JCA98/Proyecto-el-ctrico/Documentos importantes/ModeladoYControlPMSM.pdf

# Modelado y control de la máquina sincrónica de imanes permanentes

Mauricio Espinoza B.
28 de mayo de 2020

El presente documento pretende brindar los fundamentos del modelado y control de la máquina sincrónica de imanes permanentes, PMSM (también conocida como máquina ac de imanes permanentes, PMAC machine, del inglés). Tanto el modelado como el control se hacen en forma vectorial (se usará negrita para denotar una variable vectorial), donde un vector x de dos dimensiones tiene parte real e imaginaria, es decir: xαβ = xα + jxβ. Además, se utilizarán vectores de 3 dimensiones reales de la forma: xabc = [xa, xb, xc]

. A menos que se diga lo contrario, todas las variables serán medidas línea a neutro y de forma instantánea en este documento no se usan fasores. El subíndice “s” se utilizará para variables de estator, mientras que las variables con subíndice “r” serán del rotor.
I. MODELADO DE LA MÁQUINA SINCRÓNICA DE IMANES PERMANENTES

I-A. Ecuaciones dinámicas en coordenadas abc

La máquina sincrónica de imanes permanentes (PMSM, por sus siglas en inglés) se muestra en la Fig. 1.

+

+

+

N
S

Figura 1. Modelo eléctrico de la máquina sincrónica de imanes permanentes
donde el rotor de la máquina posee un imán permanente que proporciona el campo magnético que interactúa con el campo magnético producido en el estator. Para definir el sentido de las corrientes se asume “convención de motor”, es decir, las corriente entran al estator (esto es independiente de la aplicación de la máquina). Por lo tanto, es posible plantear el siguiente sistema de ecuaciones a partir del circuito de la Fig. 1:

vsa = Risa +

dλsa
dt | (1)

vsb = Risb +

dλsb
dt | (2)

vsc = Risc +

dλsc
dt | (3)

Donde el subíndice “s” se refiere a stator. Esta expresión puede ser representada en forma compacta utilizando notación vectorial de la siguiente manera:

vsabc = Risabc +

dλsabc
dt | (4)

donde vsabc = [vsa, vsb, vsc]

es el vector trifásico de tensiones de entrada, isabc = [isa, isb, isc]
| son las corrientes de estator,

λsabc = [λsa, λsb, λsc]

es el vector de flujo que llega al estator, mientras que R es la resistencia de estator. Como se indicó anteriormente, todas las variables son instantáneas y medidas entre fase y neutro (si aplica).

Aunque el modelo descrito en (4) es válido, él posee tres inconvenientes:

1. Las variables que utiliza son linealmente dependientes. Por ejemplo: isa + isb + isc = 0. Esta característica lo hace poco útil para efectos de representar la dinámica de una máquina trifásica.
2. Las variables que utiliza son sinusoidales, lo cual no es atractivo para la implementación de sistemas de control a frecuencia variable.

3. El flujo magnético del estator depende tanto de la corriente del estator como del flujo del rotor. Por lo tanto, es necesario determinar la relación existente entre estas variables para lograr un buen control de las corrientes de estator.

En lo siguiente se detallará cómo resolver cada uno de estos inconvenientes aplicando transformaciones lineales específicas o realizando cambios de variable.

I-B. Modelado de la máquina en coordenadas αβ

El primer inconveniente del modelo definido en (4) puede ser solventado aplicando la transformada de Clarke¹
. Cuando se
trabajan con señales trifásicas balanceadas, esta transformada convierte un espacio de tres variables trifásicas desfasadas 120◦ a dos variables desfasadas 90◦ por medio de la transformación:
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
- (5)

donde x es una variable trifásica cualquiera (tensión, corriente, flujo magnético, etc.), [xα, xβ]

es el vector en coordenadas αβ y [xa, xb, xc]
es el vector en coordenadas abc² . En notación vectorial compleja, el vector en coordenadas αβ se puede escribir como xαβ = xα + jxβ. Utilizando esta notación, la expresión (4) se puede escribir como:

vsαβ = Risαβ +

dλsαβ
dt | (6)

donde todas las variables son ahora de la forma a + jb, es decir: vsαβ = vsα + jvsβ, isαβ = isα + jisβ, λsαβ = λsα + jλsβ. Con este procedimiento, se ha pasado de un sistema trifásico redundante a uno bifásico cuyas variables son linealmente independientes. Así, al modelo definido en (6) se le llama el modelo de la máquina en coordenadas αβ.

I-C. Modelado de la máquina en coordenadas dq

Para eliminar el componente sinusoidal del modelo dado en (6), se puede comenzar por identificar el motivo de su presencia expresando los vectores complejos en notación polar. Es decir, definiendo:

vsαβ = vsα + jvsβ = |vsαβ|e

j(θe+θv)
| (7)
isαβ = isα + jisβ = |isαβ|e
j(θe+θi) | (8)

λsαβ = λsα + jλsβ = |λsαβ|e

j(θe+θλ)
| (9)

donde θe =

R
ωedt es el ángulo eléctrico y ωe es la frecuencia eléctrica de la máquina. En las expresiones anteriores, θv, θi y θλ son ángulos de desfase entre las variables eléctricas y se consideran constantes. Nótese que al utilizar la notación polar, se ha evidenciado que los vectores están girando a una velocidad angular ωe igual a la frecuencia eléctrica de las señales en coordenadas abc. De hecho, considerando el vector de tensiones como ejemplo, se puede escribir:

vsαβ = |vsαβ|e

j(θe+θv)

= |vsαβ|e

jθv
- e
jθe | (10)

donde la parte giratoria del vector (e

jθe

) se ha separado completamente. La parte restante, |vsαβ|e | jθv , es en realidad un vector
de fase constante que no gira, pues como se dijo antes, el ángulo θv es constante. De esta manera, para eliminar la parte giratoria del modelo (6) basta con multiplicarlo por e

−jθe
, pues e

jθe
- e

−jθe = 1, expresión que no es un vector giratorio.

Formalmente, el proceso de multiplicar un sistema por e

−jθe se denomina transformación dq, y fue propuesta por Robert H. Park en 1929. Así, al tener un vector en coordenadas αβ, este vector se puede pasar a coordenadas dq de la siguiente manera:

xdq = xαβe

−jθe | (11)

y del mismo modo, la transformada dq inversa estaría dada por:

xαβ = xdqe

jθe
| (12)

En el caso específico de la tensión vectorial utilizada como ejemplo, se tendría que:

vsdq = vsαβe

−jθe

1ver: https://es.wikipedia.org/wiki/Edith_Clarke.
2A menara de ejemplo, considérese un sistema trifásico dado por xa = X cos(θe +θ0), xb = X cos(θe −120◦ +θ0), xc = X cos(θe + 120◦ +θ0). Al aplicar la transformada de Clarke se demuestra que: xα = X cos(θe + θ0) y xβ = X sin(θe + θ0), que son dos variables desfasadas 90◦.

= |vsαβ|e

j(θe+θv)
| | {z | }
| vsαβ

e

−jθe

= |vsαβ|e

jθv

= vsd + jvsq | (13)

Entonces, aplicando la transformada dq al sistema (6) (i.e. multiplicando por e

−jθe
) se obtiene:

(vsαβ) e

−jθe = (Risαβ) e

−jθe +

dλsαβ

dt
e

−jθe
| (14)

lo que resulta en:

vsdq = Risdq +

dλsdq
dt | + jωeλsdq | (15)

donde el último miembro de (15) se debe a que se debe aplicar un “tip matemático” para calcular
dλsαβ

dt
e

−jθe
| | . Por la regla
de la cadena se sabe que:
dλsαβe

−jθe
dt | =
dλsαβ
dt e | −jθe + (λsαβ)

de⁻jθe
dt

⇒

dλsαβ

dt
e

−jθe =

dλsαβe

−jθe
dt | − (λsαβ)

de⁻jθe
dt | (16)

pero − (λsαβ)

de⁻jθe
dt = − (λsαβ) e

−jθe

d(−jθe)
dt = −jωe (λsαβ) e

−jθe
(derivada de una exponencial y definición de θe) y además d(λsαβe

−jθe )
dt | =

dλsdq
dt (definición de la transformada dq). Entonces:
dλsαβ

dt
e

−jθe =

dλsdq
dt | + jωeλsdq | (17)

Finalmente, el modelo definido en (15) es el modelo de la máquina de imanes permanentes en coordenadas dq, pero no se ha simplificado al máximo pues aún se utiliza el flujo magnético del estator, que es compuesto por la corriente de estator y el flujo magnético de rotor, lo que representa el tercer inconveniente que se debía resolver.

El flujo que llega al estator de la máquina está compuesto por el flujo producido por las corrientes del estator y por el flujo producido por el imán del rotor que es capaz de llegar hasta el estator. Matemáticamente, y utilizando coordenadas dq, esto se escribe como:

λsdq = Lisdq + λrdq | (18)

siendo L la inductancia de los devanados de estator y λrdq el flujo magnético producido por el rotor y que llega al estator. Así, sustituyendo (18) en (15) resulta:

vsdq = Risdq +

d
dt (Lisdq + λrdq)
| | {z | }

λsdq

+jωe (Lisdq + λrdq)
| | {z | }

λsdq

⇒ | (19)

vsdq = Risdq + L

disdq
dt +

dλrdq
dt | + jωeLisdq + jωeλrdq | (20)

donde ahora solo se utilizan las corrientes y tensiones de estator, el flujo magnético de rotor y la frecuencia eléctrica como variables en el modelo. El modelo dado en (20) se denomina modelo dq general y sin una orientación específica, pues no se ha definido aún qué ángulo inicial se considerará en el sistema. El proceso de elegir el ángulo inicial del sistema se denomina orientación del sistema, y dependiendo de su elección se afectará el valor de θe, θv, θi
, etc. Para visualizar los efectos de la orientación del eje dq en el modelo (20), este modelo se separá en los componentes real (d) e imaginario (q), resultando en:

vsd = Risd + L

disd
dt +

dλrd
dt − ωeLisq − ωeλrq | (21)

vsq = Risq + L

disq
dt +

dλrq
dt + ωeLisd + ωeλrd | (22)

Aunque es posible orientar el modelo descrito en (21) y (22) de muchas maneras, para efectos de control es conveniente orientar el eje dq en el flujo de rotor. Esto produce que λrdq = λrd + j0 (i.e. λrq = 0). Además, si se supone flujo de rotor constante (lo que es válido pues la máquina es de imanes permanentes), se tiene: dλrd
dt = 0 y

dλrq
dt = 0. Por lo tanto, (21) y
(22) resultan en:

vsd = Risd + L

disd
dt − ωeLisq | (23)

vsq = Risq + L

disq
dt + ωeLisd + ωeλrd | (24)

Finalmente, (23) y (24) son el el modelo dinámico de la máquina sincrónica de imanes permanentes en coordenadas dq orientadas en el flujo de rotor. Este modelo es el más utilizado en el control y modelado de las máquinas de imanes permanentes.

I-D. Modelo electromecánico de la máquina

El modelo electromecánico de las máquinas rotativas es similar en todos los casos, y está dado por:

J

dωr
dt = Te − TL | (25)

donde ωr es la velocidad rotacional mecánica, en rad/s, TL y Te son los torques de carga y eléctrico, en Nm, y J es la inercia rotacional, en kgm²
. Nótese que pωr = ωe, donde p es el número de pares de polos. No obstante, es poco común trabajar directamente con el torque eléctrico. En su lugar, se suele trabajar con las corrientes de la máquina, que son más fáciles de medir. En lo siguiente, se muestra cómo modelar el torque eléctrico en función de otras variables de la máquina.

En forma general, se puede demostrar que la potencia activa trifásica de un sistema cuyas variables están expresada en coordenadas dq es:

pe =

3
2

< {(vsd + jvsq) (isd − jisq)} ⇒

pe =

3
2
(vsdisd + vsqisq) | (26)

donde el factor 3
2

se debe a la transformada de Clarke utilizada (conservativa en amplitud).

Ahora bien, considerando que la resistencia del devanado de la máquina es pequeña y que las corrientes dq están en estado estacionario, las expresiones (23) y (24) resultan:

vsd ≈ −ωeLisq | (27)
vsq ≈ ωeLisd + ωeλrd | (28)

y sustituyendo (27) y (28) en (26) se llega a que la potencia eléctrica de la máquina es:

pe ≈

3
2
ωeλrdisq | (29)

Finalmente, considerando que pe ≈

Teωe
p

, el torque eléctrico (Te) de la máquina se obtiene al dividir (29) por ωe
p
| , es decir:

Te ≈

3
2
pλrdisq | (30)

La expresión (30) indica que cuando se utiliza orientación en el flujo de rotor, la máquina sincrónica de imanes permanentes se puede controlar como si fuera una máquina dc, donde el flujo y el torque están desacoplados. Por ejemplo, en este caso el flujo de rotor es impuesto por el imán permanente, mientras que la corriente de cuadratura define el torque aplicado a la máquina, es decir, la corriente de eje de cuadratura resulta equivalente a la corriente de armadura de la máquina dc, lo cual posibilita la implementación de estrategias de control con una respuesta dinámica bastante alta. De esta manera, sustituyendo
(30) en (25) se obtiene:

J

dωr
dt =

3
2
pλrdisq − TL | (31)

Finalmente, (31), (24) y (23) representan el modelo de la máquina sincrónica de imanes permanentes con orientación en el flujo de rotor. Estas ecuaciones se colocan juntas y despejando los estados del sistema para simplicidad del lector:

L

disd
dt = −Risd + ωeLisq + vsd | (32)

L

disq
dt = −Risq − ωeLisd − ωeλrd + vsq | (33)

J
p

dωe
dt =

3
2
pλrdisq − TL | (34)

donde se ha utilizado el hecho de que ωe = ωrp para dejar el modelo en función de los estados ωe, isd, isq y las entradas vsd, vsq (que son las tensiones que se pueden manipular) y λrd, que es una entrada que se considera constante.

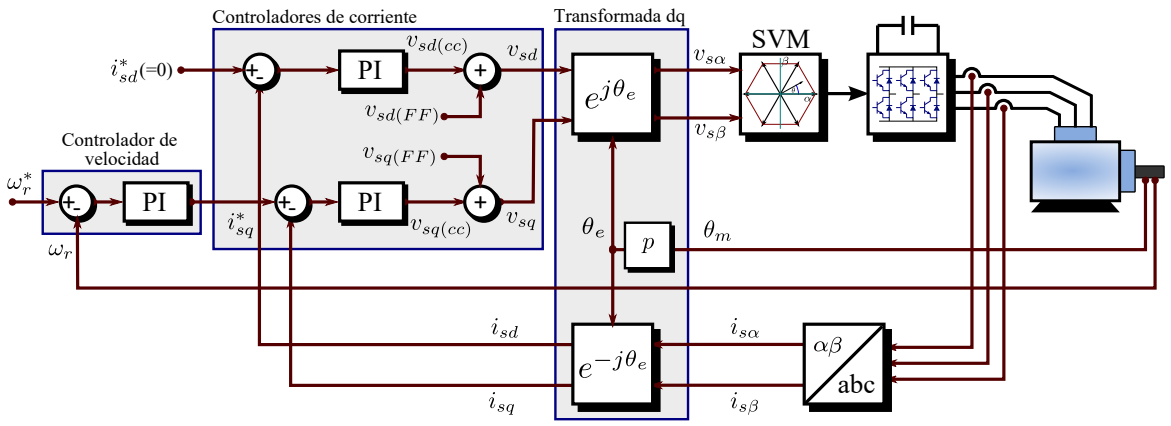
[picture p1: figure]
SVM; abc; Controladores de corriente; Controlador de velocidad; Transformada dq

Figura 2. Control vectorial orientado en el flujo de rotor para la PMSM

II. CONTROL DE LA MÁQUINA SINCRÓNICA DE IMANES PERMANENTES

II-A. Medición de las variables eléctricas disponibles en la máquina

Dado que el modelado de la máquina se realizó en coordenadas dq orientadas en el flujo de rotor de la máquina, es necesario transformar las variables reales de la máquina, en coordenadas abc, a coordenadas dq con el ángulo eléctrico del vector de flujo de rotor. Para ello, se puede aplicar cualquiera de los dos procedimientos descritos en [1], con el fin de definir el ángulo de giro inicial de la máquina. Una vez definido este ángulo, se puede aplicar la transformada abc a dq y dq a abc, esto se muestra en la figura 2. Nótese que el ángulo eléctrico θe es definido en función del ángulo mecánico θm, utilizando los pares de polos de la máquina, p.

II-B. Control de las corrientes de la máquina

A partir de (23) y (24), se determina que las corrientes isd e isq pueden ser controladas manipulando, respectivamente, las tensiones vsd y vsq. Sin embargo, nótese que los últimos miembros de (23) y (24) corresponden a términos de acoplamiento, los cuales pueden ser considerados como perturbaciones desde un punto de vista de control. Para eliminar estas perturbaciones, las tensiones por aplicar a la máquina pueden ser definidas como:

vsd = vsd(c) + vsd(F F )
(35)

vsq = vsq(c) + vsq(F F )
(36)

donde el subíndice (c) indica “definido por un controlador” y el subíndice (F F) indica “FeedForward” (prealimentación, compensación o desacople). Las variables definidas con el subíndice (F F) son las responsables de eliminar los acoples del modelo de la máquina. Por ejemplo, si vsd(F F ) y vsq(F F ) se definen como:

vsd(F F ) = −ωeLisq | (37)
vsq(F F ) = ωeLisd + ωeλrd | (38)

al sustituir (37) y (38) en (23) y (24), se obtiene:

vsd(c) = Risd + L

disd
dt | (39)

vsq(c) = Risq + L

disq
dt | (40)

Por lo que los acoples entre las corriente dq han sido eliminados, y la función de transferencia entre las corrientes isd e isq y las tensiones vsq(c) y vsq(c)
resultan en plantas de primer orden que pueden ser fácilmente controlables por PIs convencionales. Estos PIs se pueden sintonizar utilizando cancelación de polos y ceros, para lograr el ancho de banda a lazo cerrado buscado.

II-C. Control de la velocidad

Para obtener la planta de velocidad se pueden aplicar dos enfoques. En ambos se utiliza la corriente isq como variable manipulada:

1. Analítico: de (30) en (25), se obtiene:

J

dωr
dt =

3
2
pλrdisq − TL | (41)

por lo tanto, si el flujo se considera constante (lo cual es usual en la mayoría de las aplicaciones), la función de transferencia entre ωr(s) y isq(s), considerando TL = 0, es:

ωr(s)
isq(s)

=

3pλrd
2Js

(42)

2. Experimental: teniendo el lazo de corriente de cuadratura cerrado, y el lazo de velocidad abierto, aplicar un escalón en el valor deseado i

∗
sq y medir la velocidad mecánica resultante ωr. Con este enfoque, se obtendría una función de transferencia experimental que debería ser semejante a la obtenida con el enfoque analítico, pero con la ventaja de que se incorporan otras dinámicas no modeladas. Es importante notar que esta prueba debe realizarse sin torque de carga aplicado (esto es, TL = 0), y que la respuesta de la velocidad debe ser registrada con cuidado, pues su relación con la corriente isq es integrante (ver (42)) y por tanto la máquina acelerará continuamente. No existe un valor estándar para el escalón que se debe aplicar en isq durante esta prueba, pero el 10 % del valor nominal de la corriente de la máquina debería funcionar sin problemas.

III. APLICACIONES EÓLICAS DE LA MÁQUINA DE IMANES PERMANENTES

to be done :)

REFERENCIAS

[1] V. Slapk, K. Kyslan, F. Mejdr, and F. Durovsky, “Determination of Initial Commutation Angle Offset of Permanent Magnet Synchronous Machine - An Overview and Simulation,” Acta Electrotechnica et Informatica, vol. 14, DOI 10.15546/aeei-2014-0035, (http://dx.doi.org/10.15546/aeei-2014-0035) no. 4, pp. 17–22, 2014.
