JCA98/Proyecto-el-ctrico/PCB/diseñosjasiel/0805YC104KAT2A/3D/0805YC104KAT2A.stp

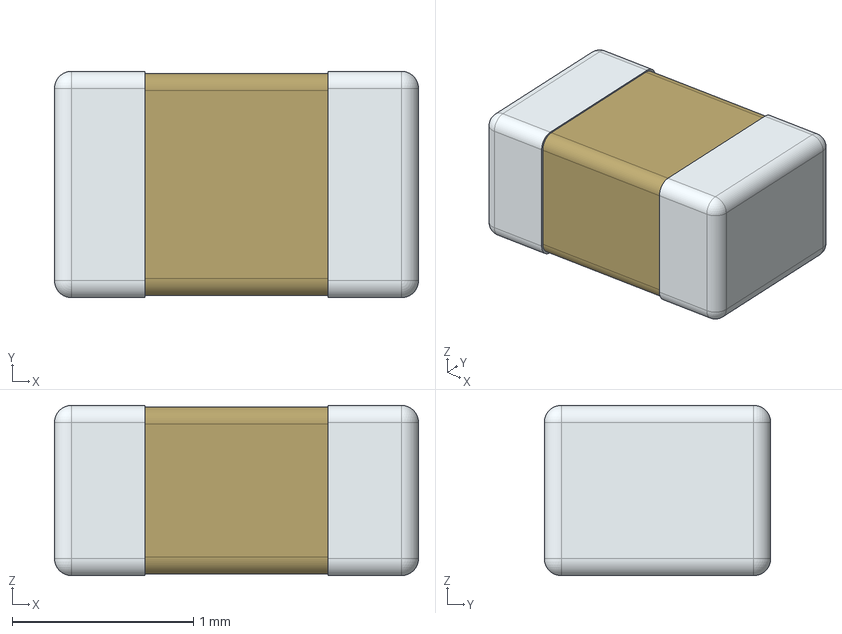
[picture p2: CAD file, 2021-06-20]
PCB/diseñosjasiel/0805YC104KAT2A/3D/0805YC104KAT2A.stp
2.01 x 1.25 x 0.94 mm
