JCA98/Proyecto-el-ctrico/PCB/diseñosjasiel/224PPB250K/3D/224PPB250K.stp

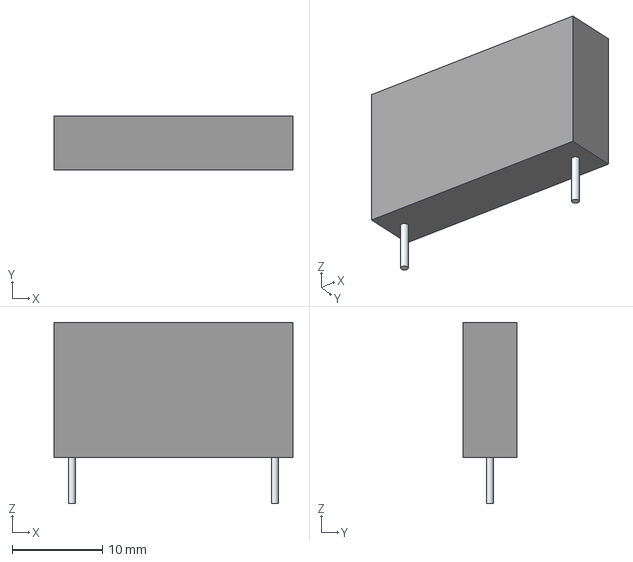
[picture p3: CAD file, 2021-06-16]
PCB/diseñosjasiel/224PPB250K/3D/224PPB250K.stp
26.5 x 6.00 x 20.1 mm
Leads
