JCA98/Proyecto-el-ctrico/PCB/diseñosjasiel/ALS70A362KE250/3D/ALS70A362KE250.stp

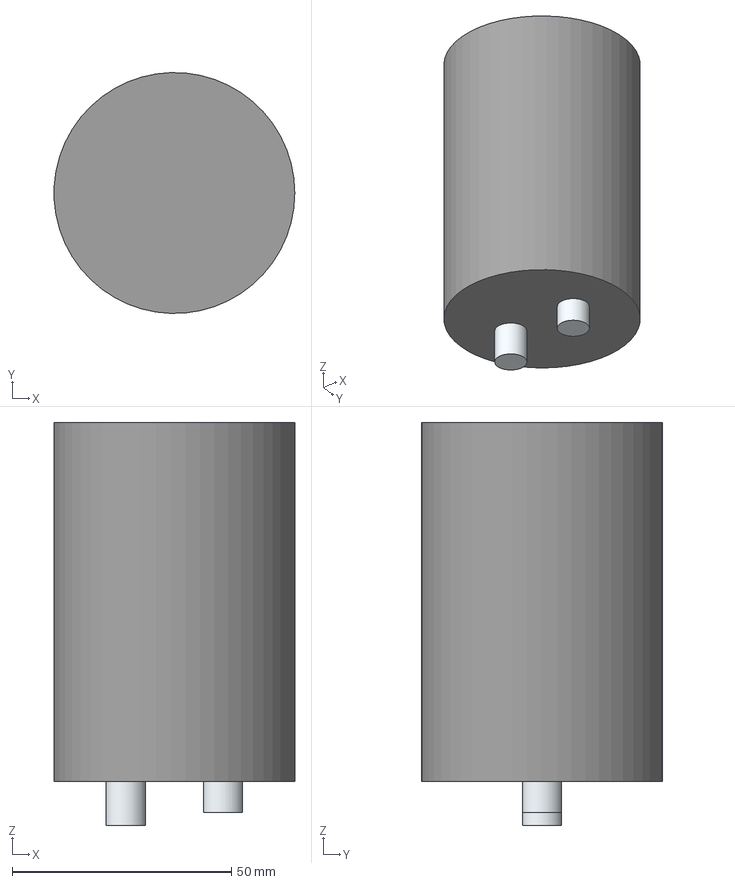
[picture p4: CAD file, 2021-07-05]
PCB/diseñosjasiel/ALS70A362KE250/3D/ALS70A362KE250.stp
54.9 x 55.0 x 92.0 mm
SimpleBody
Pin1
Pin2
