JCA98/Proyecto-el-ctrico/PCB/diseñosjasiel/C0805Y102K3RACTU/3D/C0805Y102K3RACTU.stp

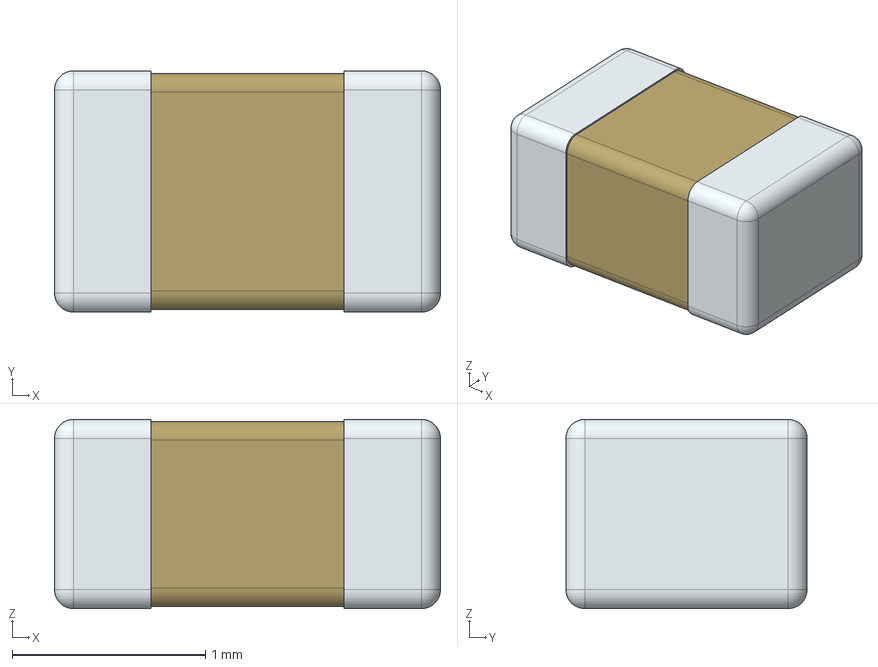
[picture p5: CAD file, 2021-06-20]
PCB/diseñosjasiel/C0805Y102K3RACTU/3D/C0805Y102K3RACTU.stp
2.00 x 1.25 x 0.98 mm
