JCA98/Proyecto-el-ctrico/PCB/diseñosjasiel/FCH041N60F/3D/FCH041N60F.stp

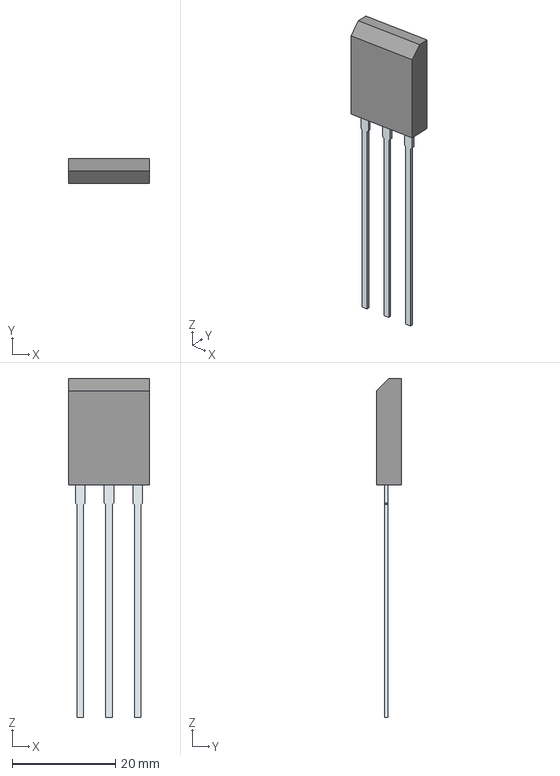
[picture p6: CAD file, 2021-06-16]
PCB/diseñosjasiel/FCH041N60F/3D/FCH041N60F.stp
15.6 x 4.82 x 65.5 mm
PinsArray
