JCA98/Proyecto-el-ctrico/PCB/User Library-CR2012-0805.step

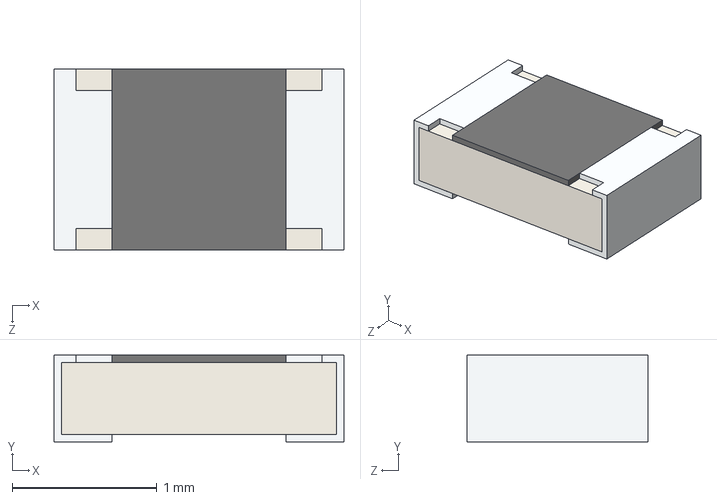
[picture p7: CAD file, 2021-06-15]
PCB/User Library-CR2012-0805.step
2.00 x 0.6 x 1.25 mm
