JCA98/Proyecto-el-ctrico/(list of files, cad)

Other CAD files:
PCB/diseñosjasiel/0805YC104KAT2A/3D/0805YC104KAT2A.stl
PCB/diseñosjasiel/0805YC104KAT2A/DEHDL/0805yc104kat2a/chips/chips.prt
PCB/diseñosjasiel/224PPB250K/3D/224PPB250K.stl
PCB/diseñosjasiel/224PPB250K/DEHDL/224ppb250k/chips/chips.prt
PCB/diseñosjasiel/ALS70A362KE250/3D/ALS70A362KE250.stl
PCB/diseñosjasiel/C0805Y102K3RACTU/3D/C0805Y102K3RACTU.stl
PCB/diseñosjasiel/FCH041N60F/3D/FCH041N60F.stl
PCB/diseñosjasiel/FCH041N60F/DEHDL/fch041n60f/chips/chips.prt
