JCA98/Proyecto-el-ctrico/Schematic/H-Bridge schematic.PDF

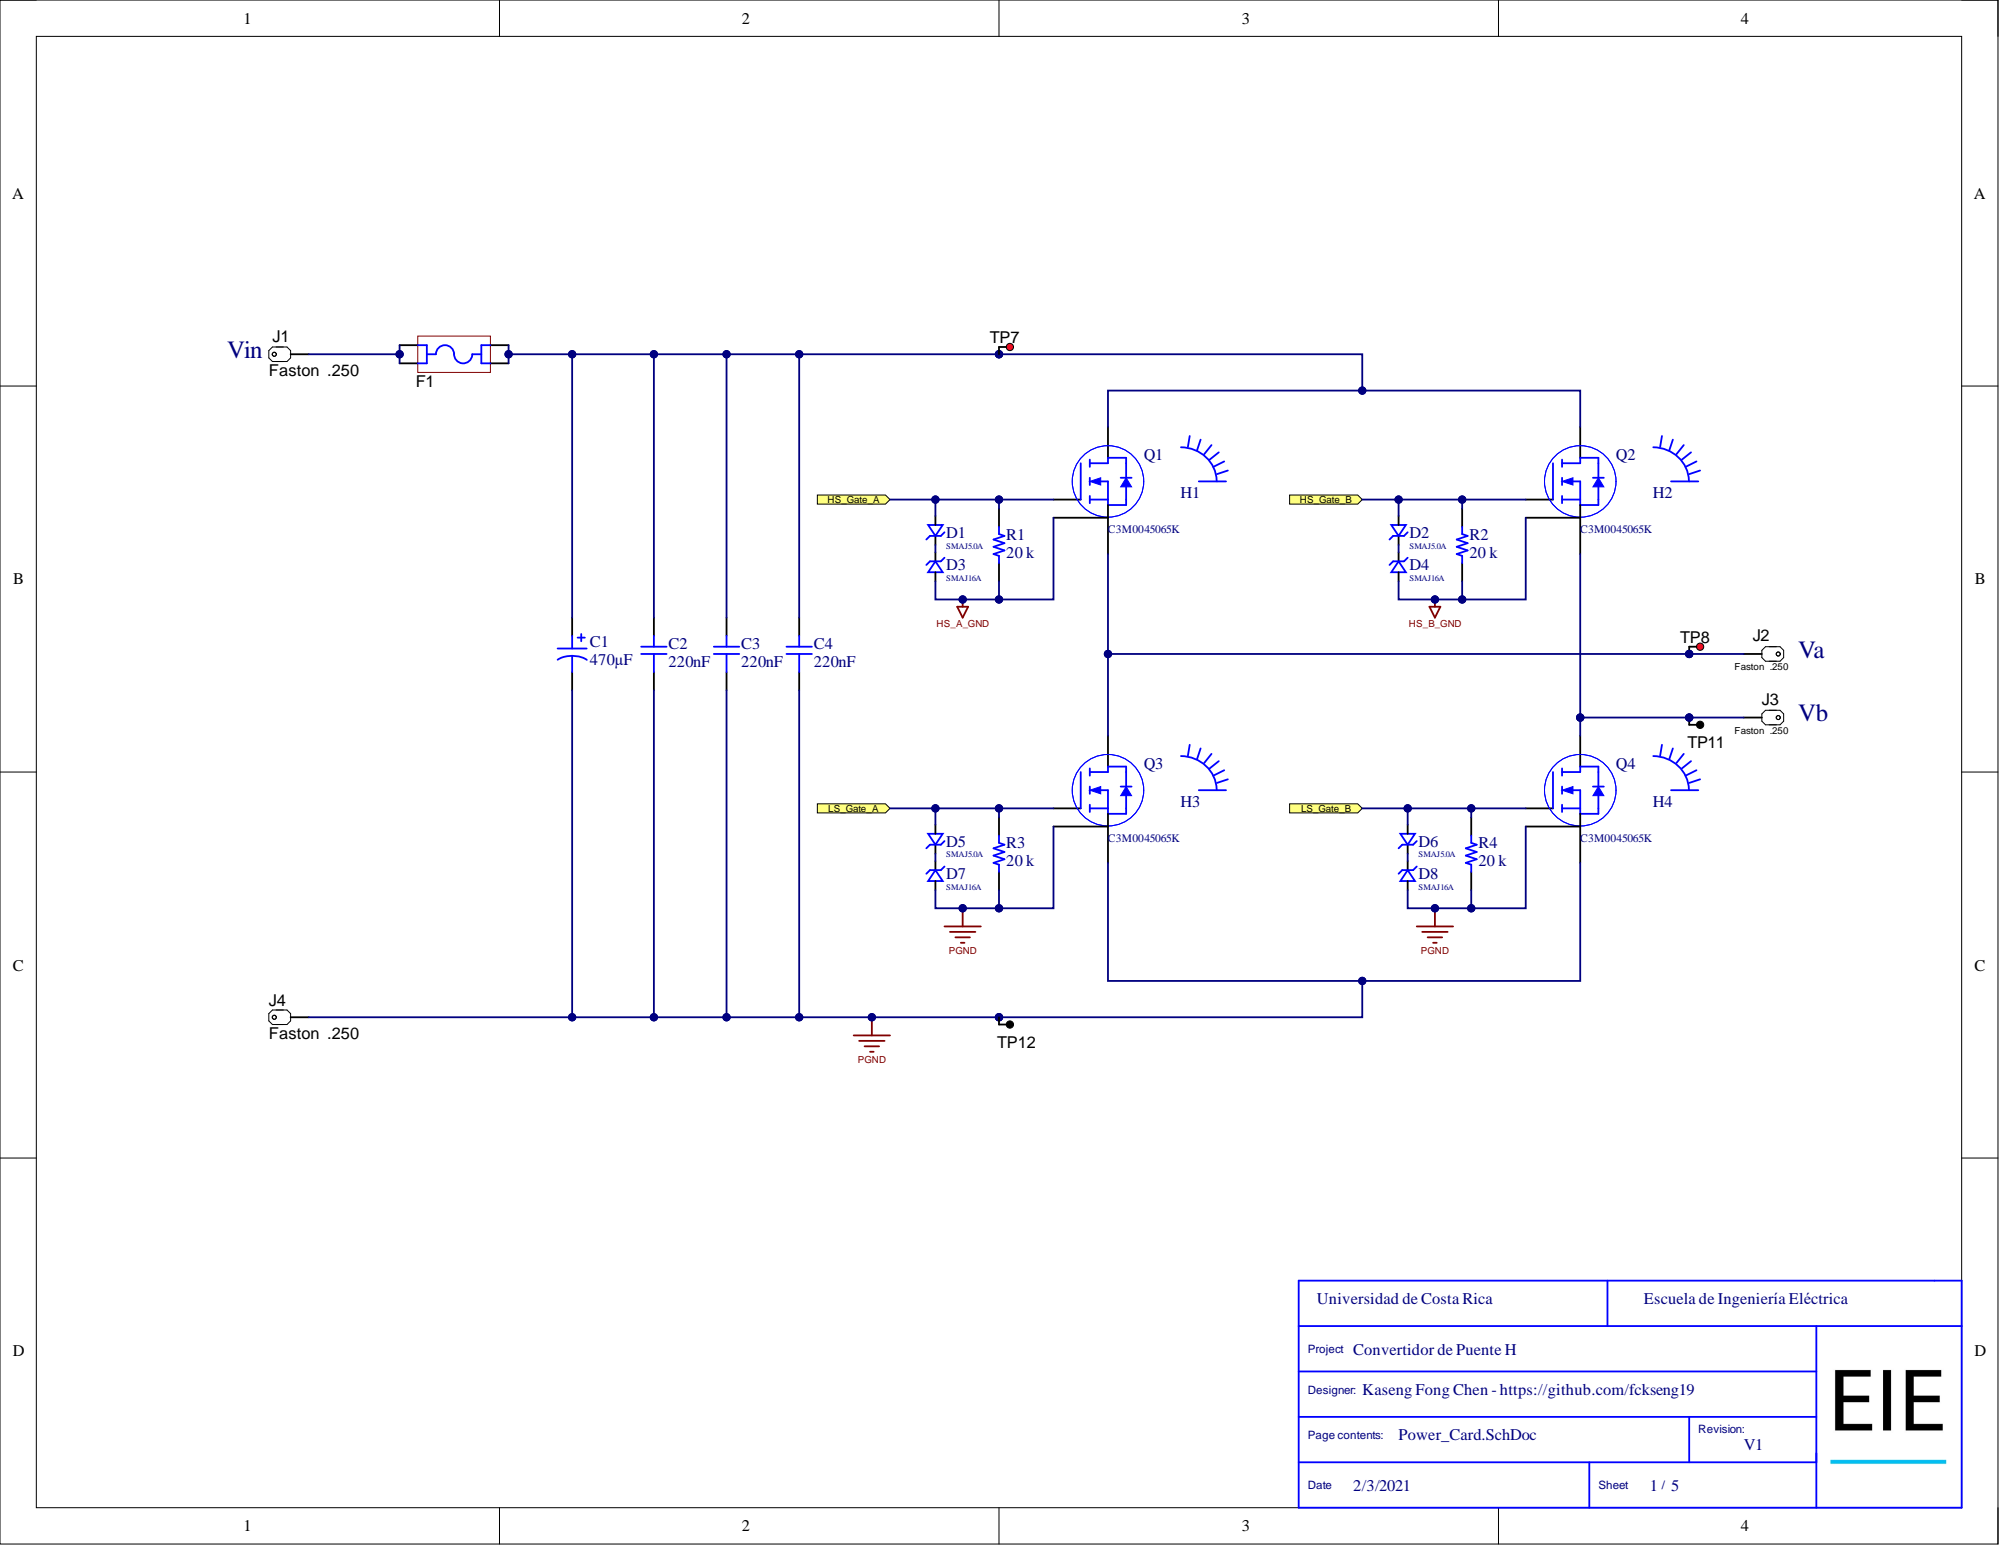
[picture p8: page 1]

U n i vers i dad de Co s ta Rica | E scuela de In gen ier ía E l éctrica

P r o j e c t Co n vert i d or de Puen te H

P g c ts : Po wer_Card.Sch | R v i s o n :V

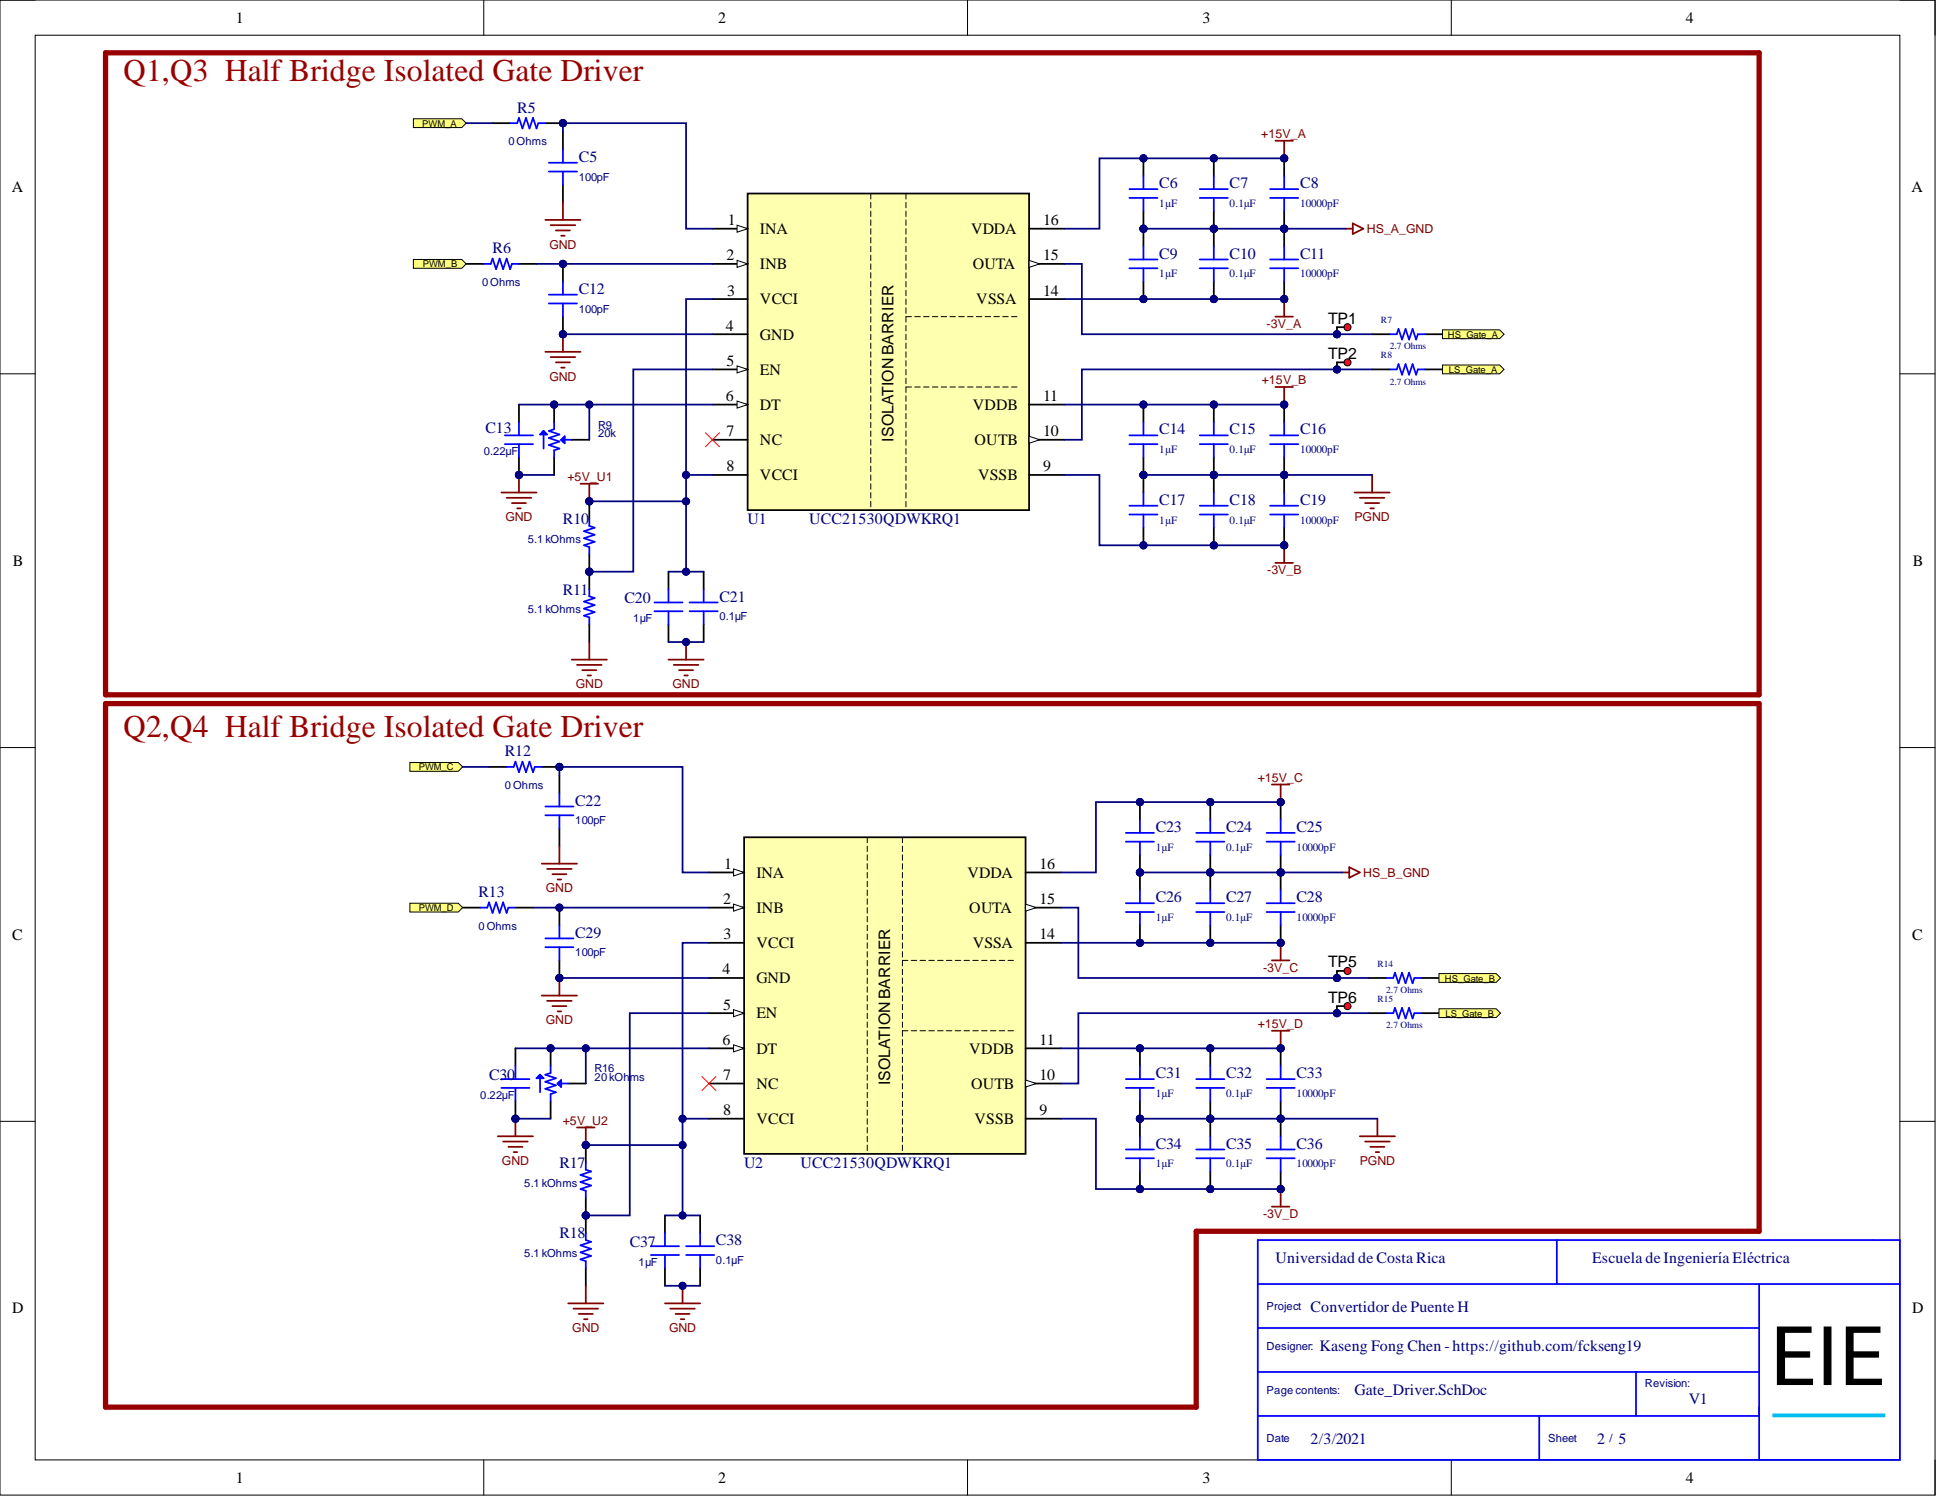
[picture p9: page 2]

Q1,Q3 Half Bridge Isolated Gate Driver

Q2,Q4 Half Bridge Isolated Gate Driver

R 1 6 2 0 k O hms | | 7 | 1 0 | C3 1 | C3 2

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

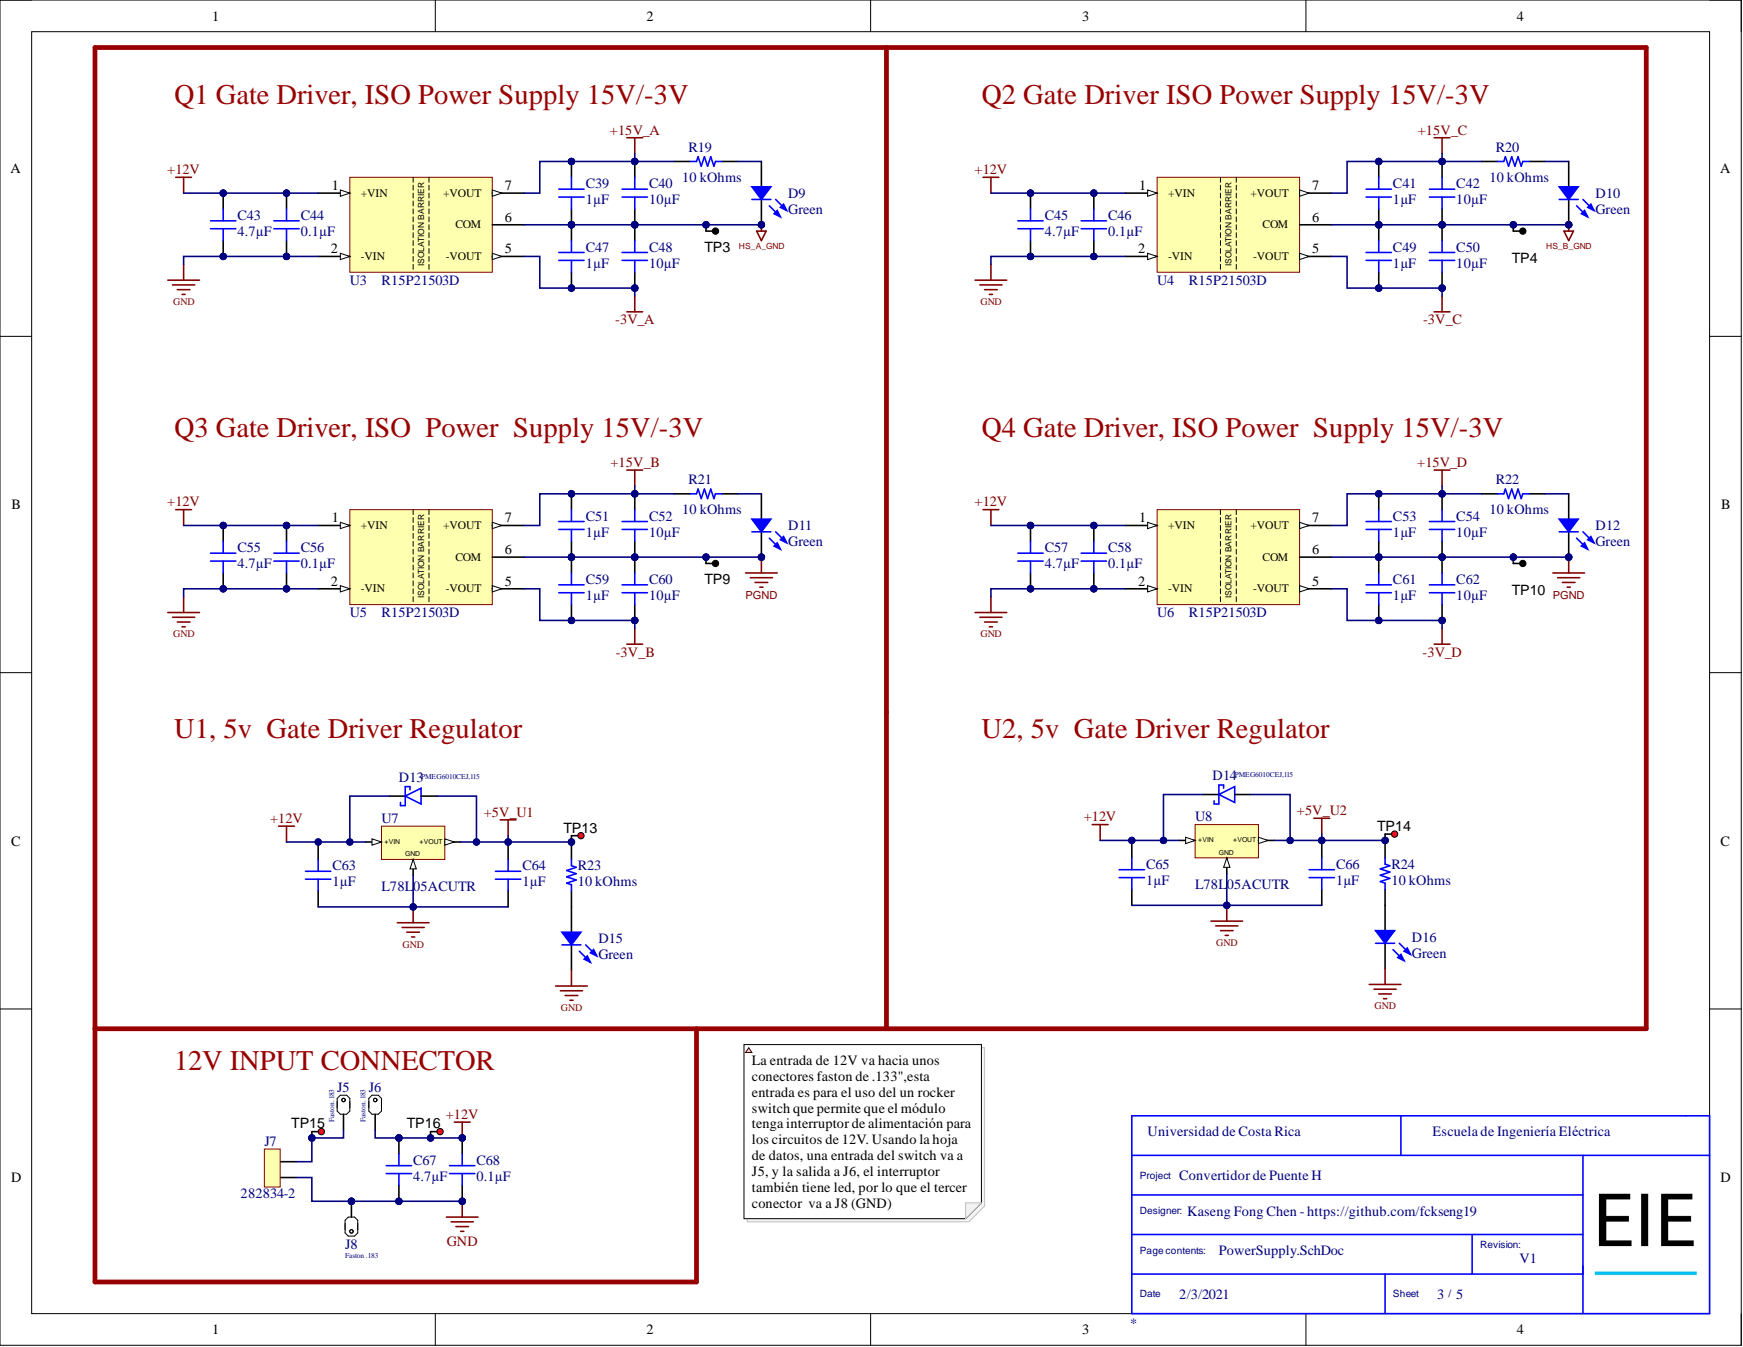
[picture p10: page 3]

Q1 Gate Driver, ISO Power Supply 15V/-3V

Q2 Gate Driver ISO Power Supply 15V/-3V

Q3 Gate Driver, ISO Power Supply 15V/-3V

Q4 Gate Driver, ISO Power Supply 15V/-3V

conectoresfaston de .133",esta
entrada es para el uso del un rocker
switch que permite que el módulo
tenga interruptor de alimentación para
los circuitos de 12V. Usando la hoja
de datos, una entrada del switch va a
J5, y la salida a J6, el interruptor
también tiene led, por lo que el tercer
conector va a J8 (GND)

Universidad de Costa Rica | Escuela de Ingeniería Eléctrica

Project Convertidor de Puente H

Kaseng Fong Chen - https://github.com/fckseng19

PowerSupply.SchDoc | Revision: V1 Page contents:

Date 2/3/2021 | Sheet 3 / 5

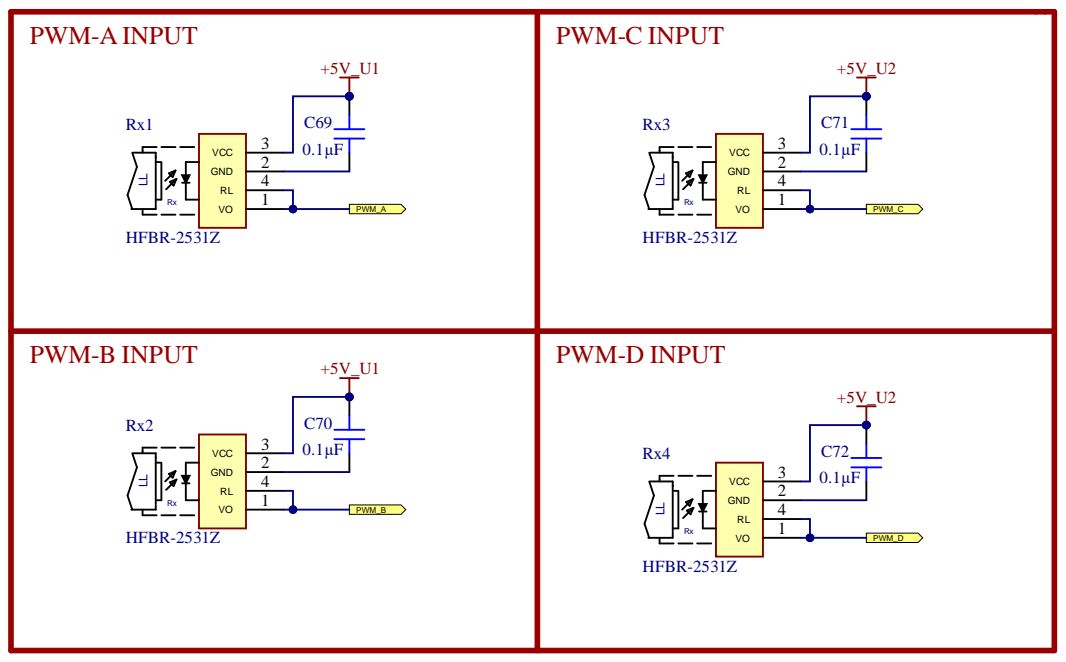
[picture p11: page 4]
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

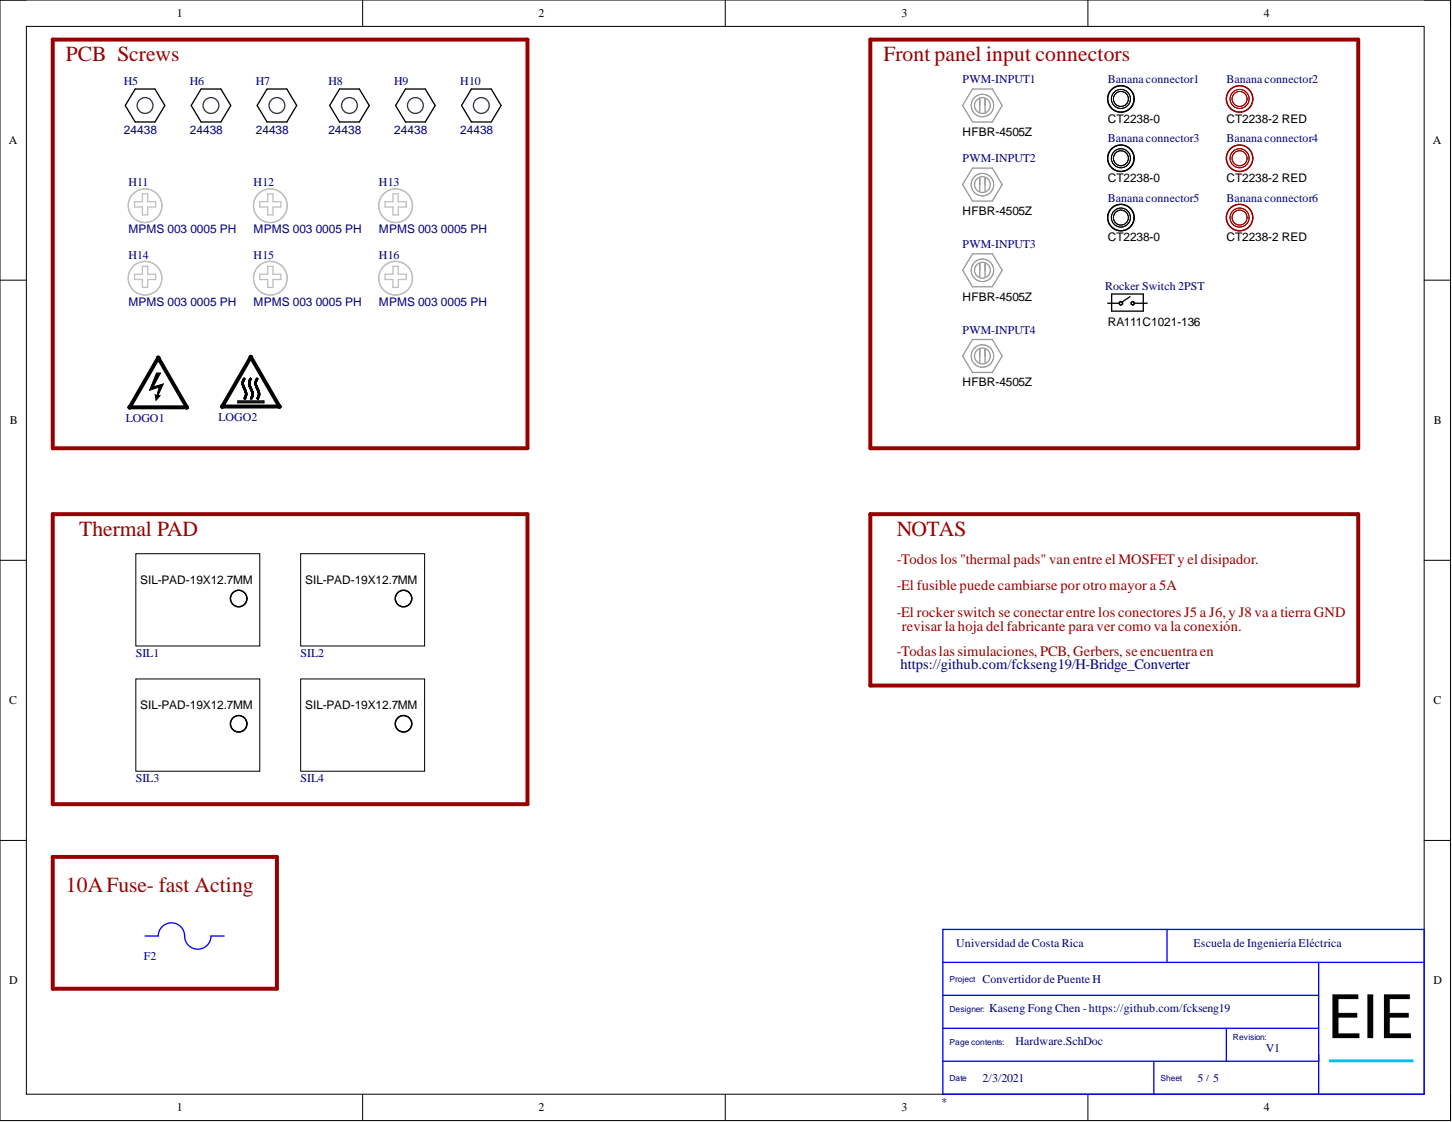
[picture p12: page 5]

-Todos los "thermal pads" van entre el MOSFET y el disipador.

-El fusible puede cambiarse por otro mayor a 5A

-El rocker switch se conectar entre los conectores J5 a J6, y J8 va a tierra GND
revisar la hoja del fabricante para ver como va la conexión.

https://github.com/fckseng19/H-Bridge_Converter -Todas las simulaciones, PCB, Gerbers, se encuentra en

Universidad de Costa Rica | Escuela de Ingeniería Eléctrica

Project Convertidor de Puente H

Kaseng Fong Chen - https://github.com/fckseng19

Hardware.SchDoc | Revision: V1 Page contents:

Date 2/3/2021 | Sheet 5 / 5
