JCA98/Proyecto-el-ctrico/Documentos importantes/Modulo_Multinivel.pdf

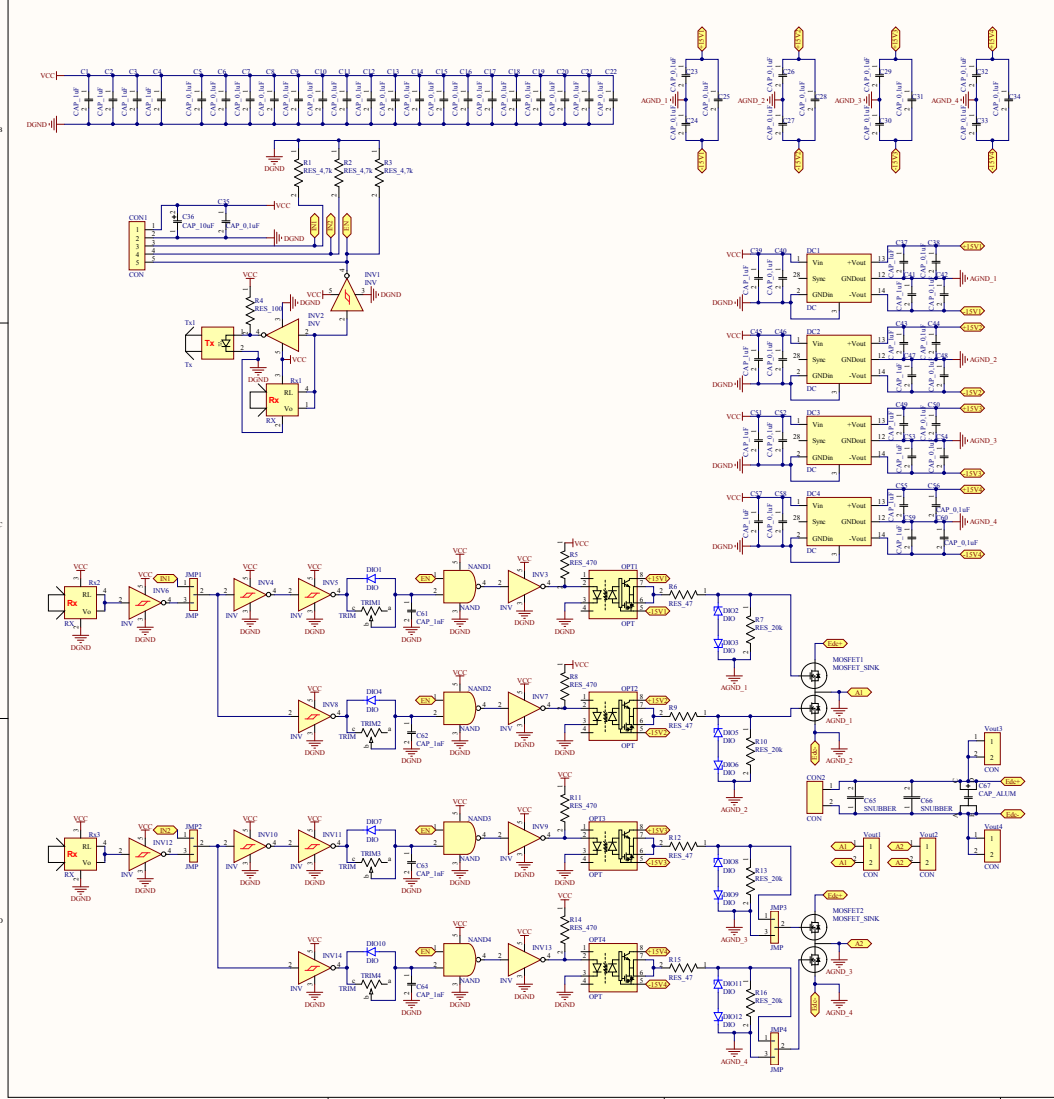
[picture p19: page 1]

2 | SNUBBER 1 2 C65

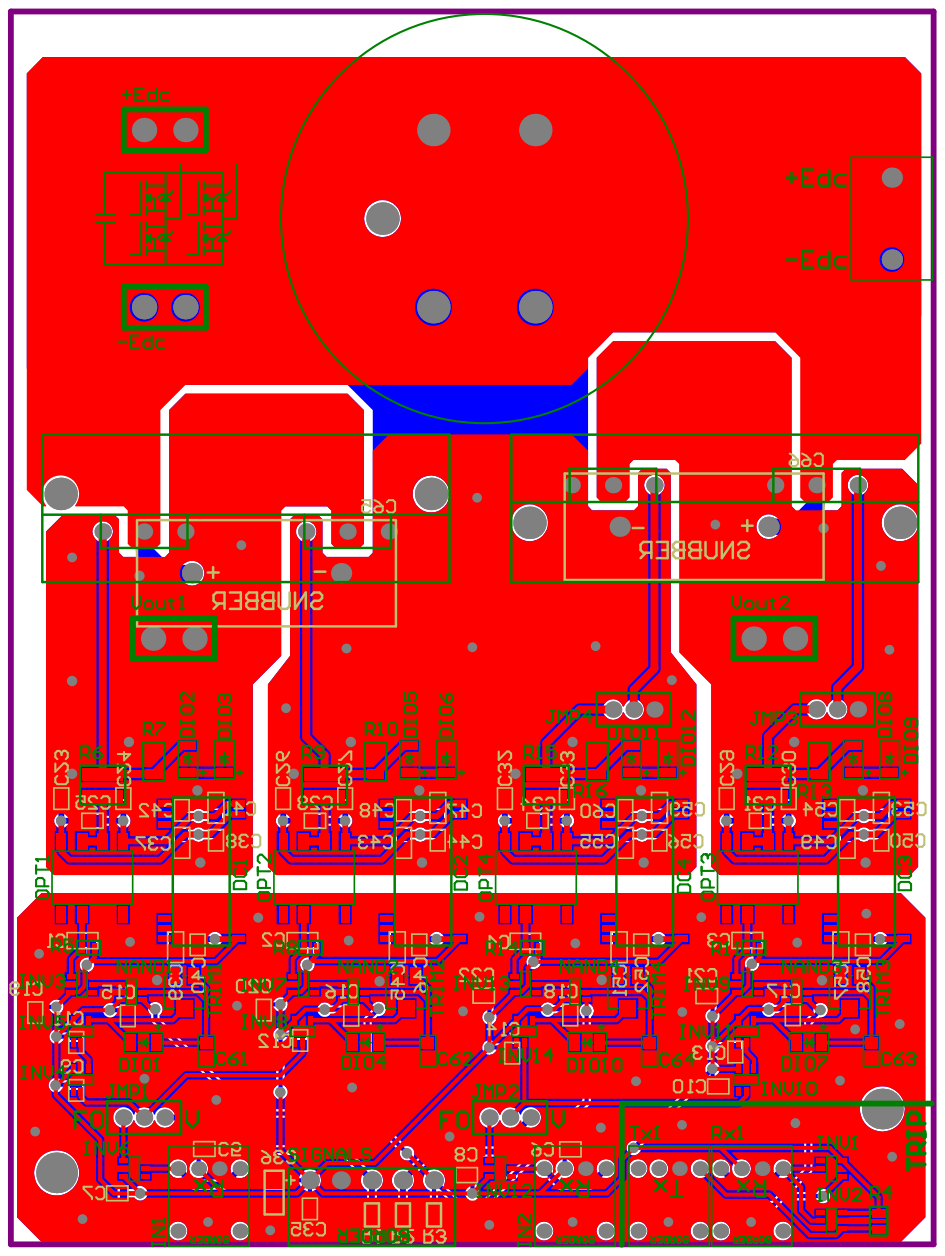
[picture p20: page 2]

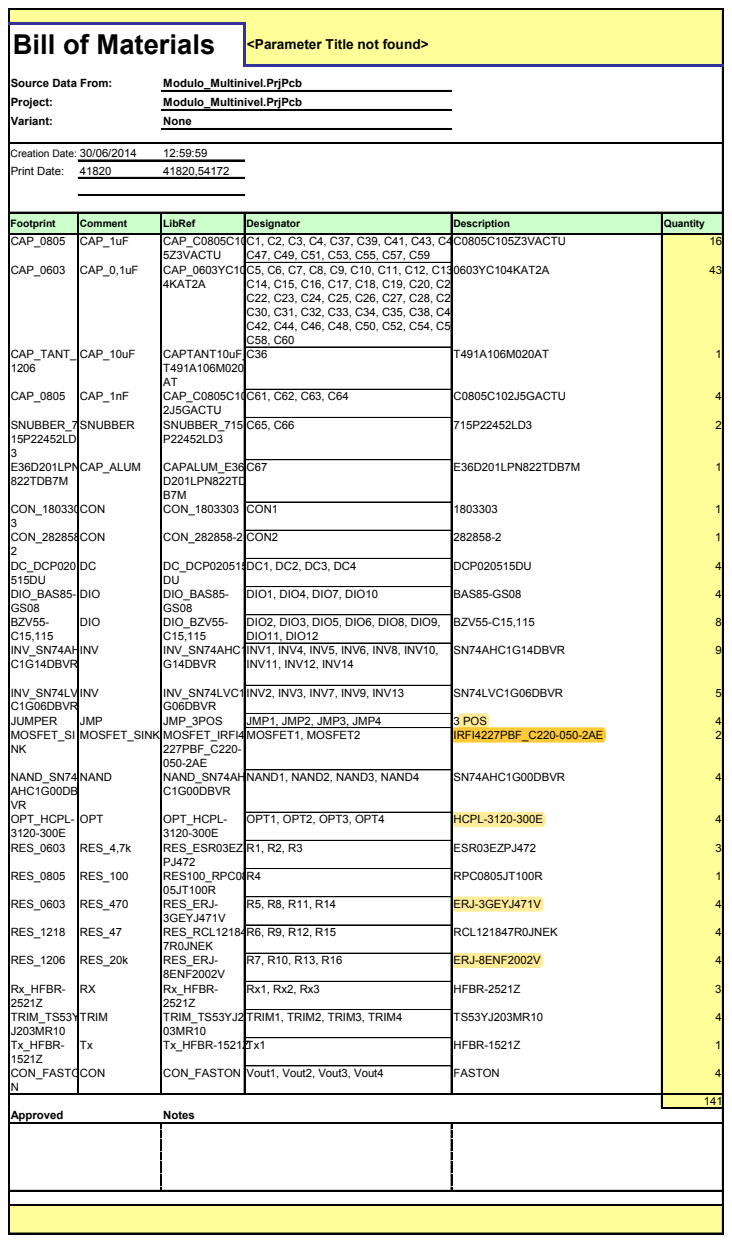
[picture p21: page 3]

Footprint | Comment | LibRef | Designator | Description | Quantity
