JCA98/Proyecto-el-ctrico/PCB/Project Outputs for Full_Bridge_Converter/Layers Prinout/Layers.PDF

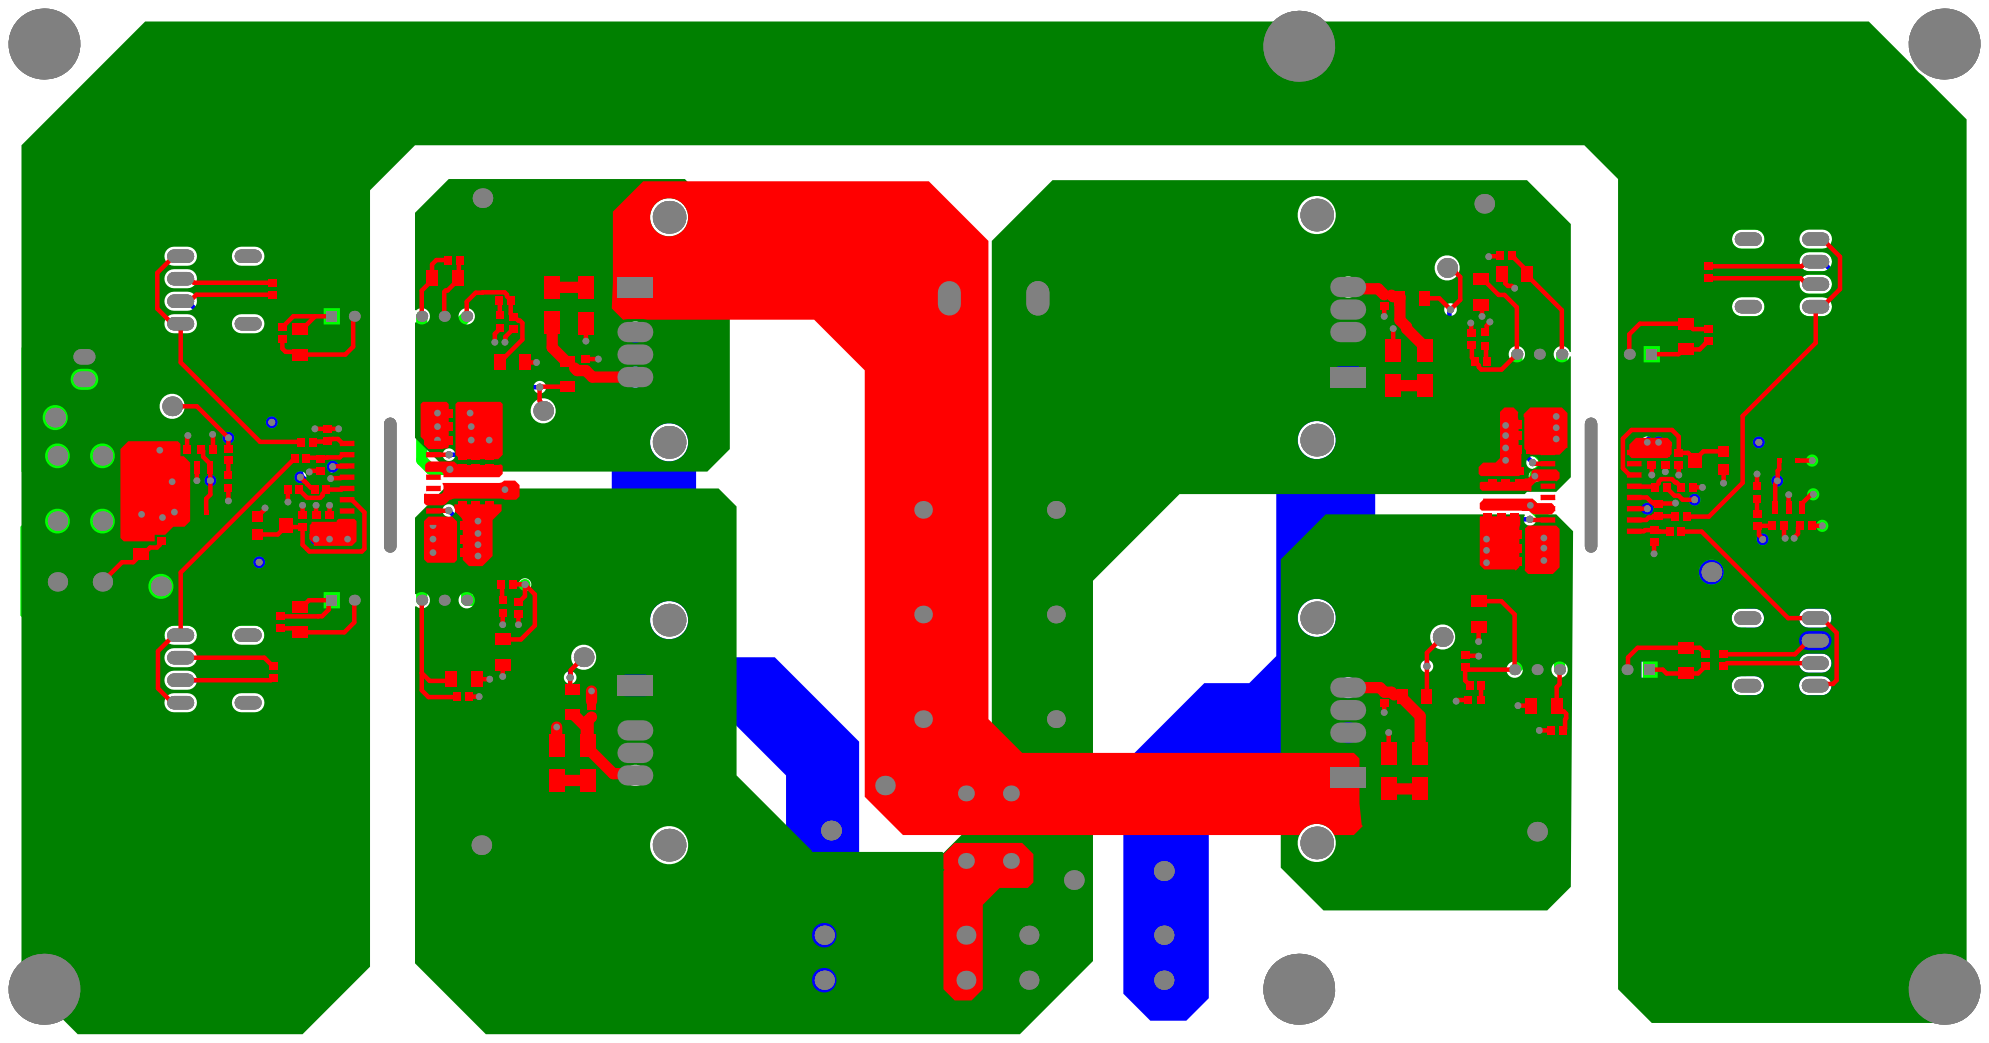
[picture p22: page 1]

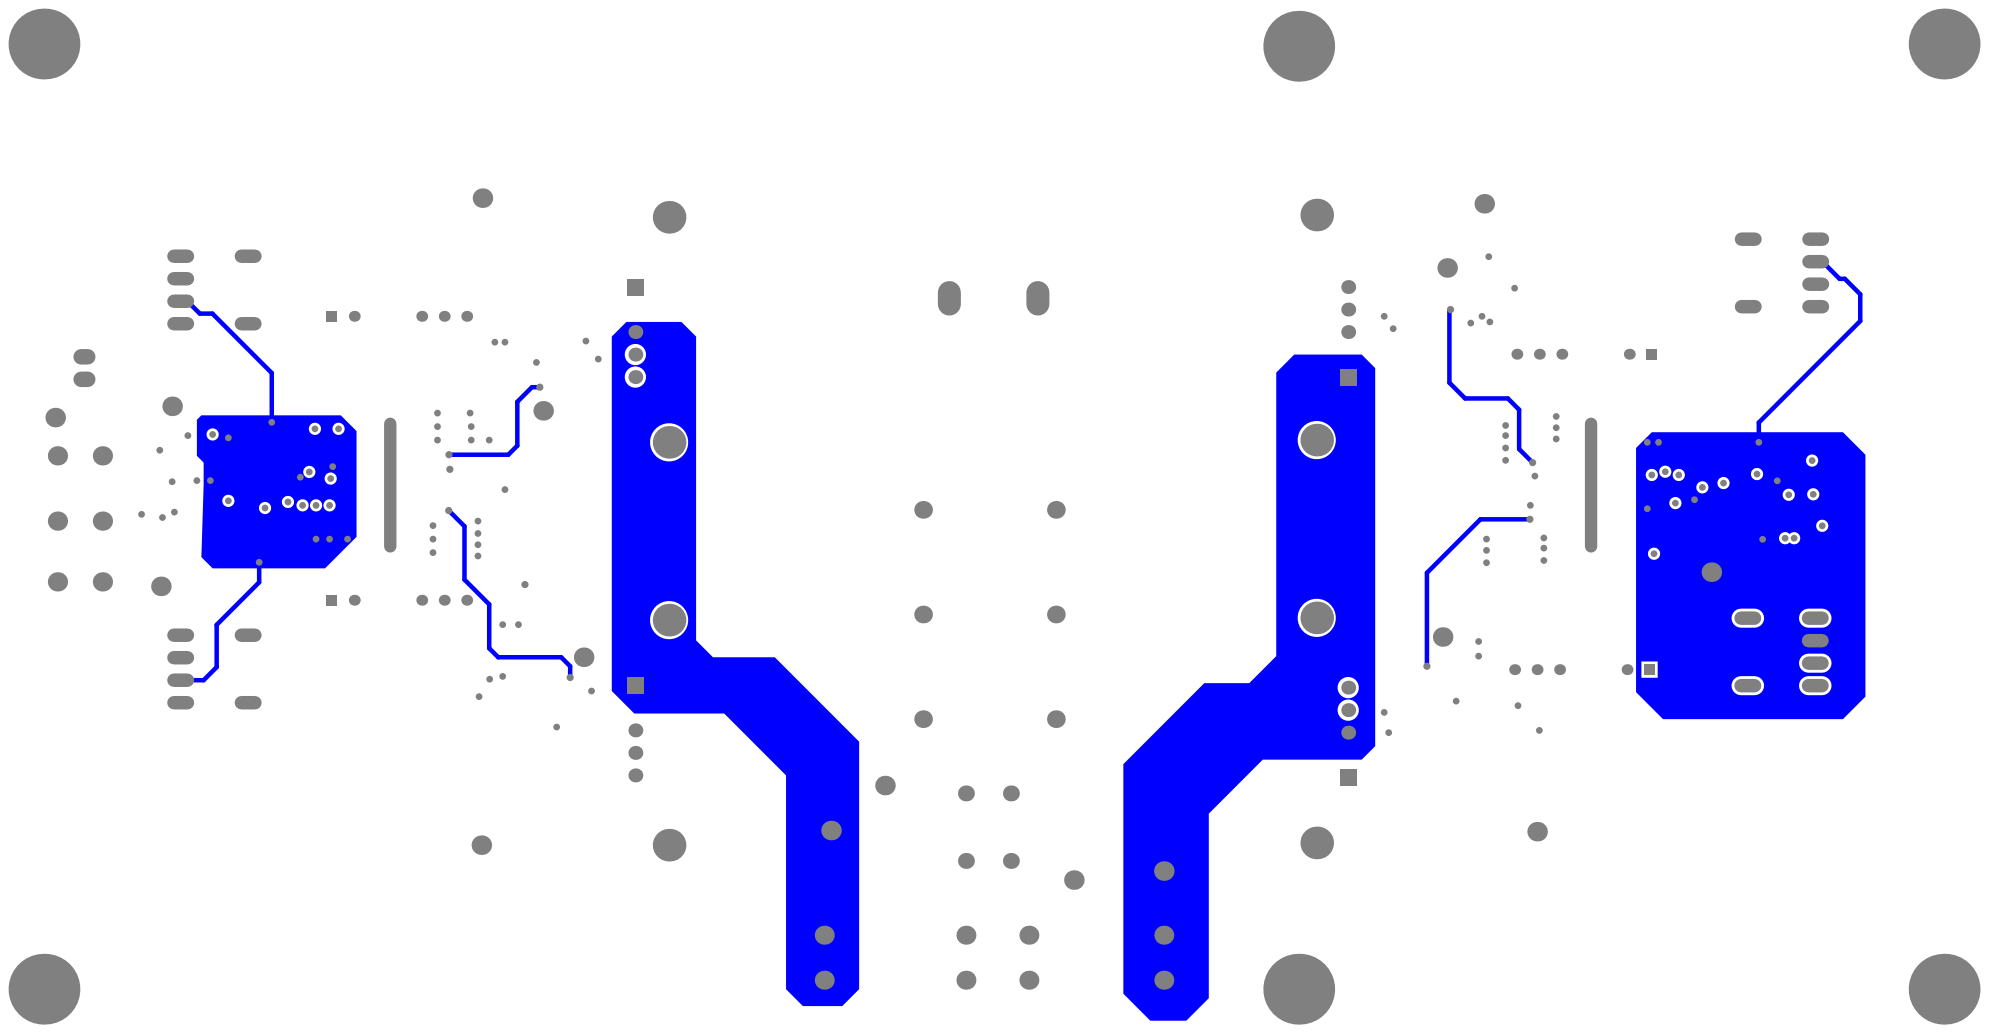
[picture p23: page 2]

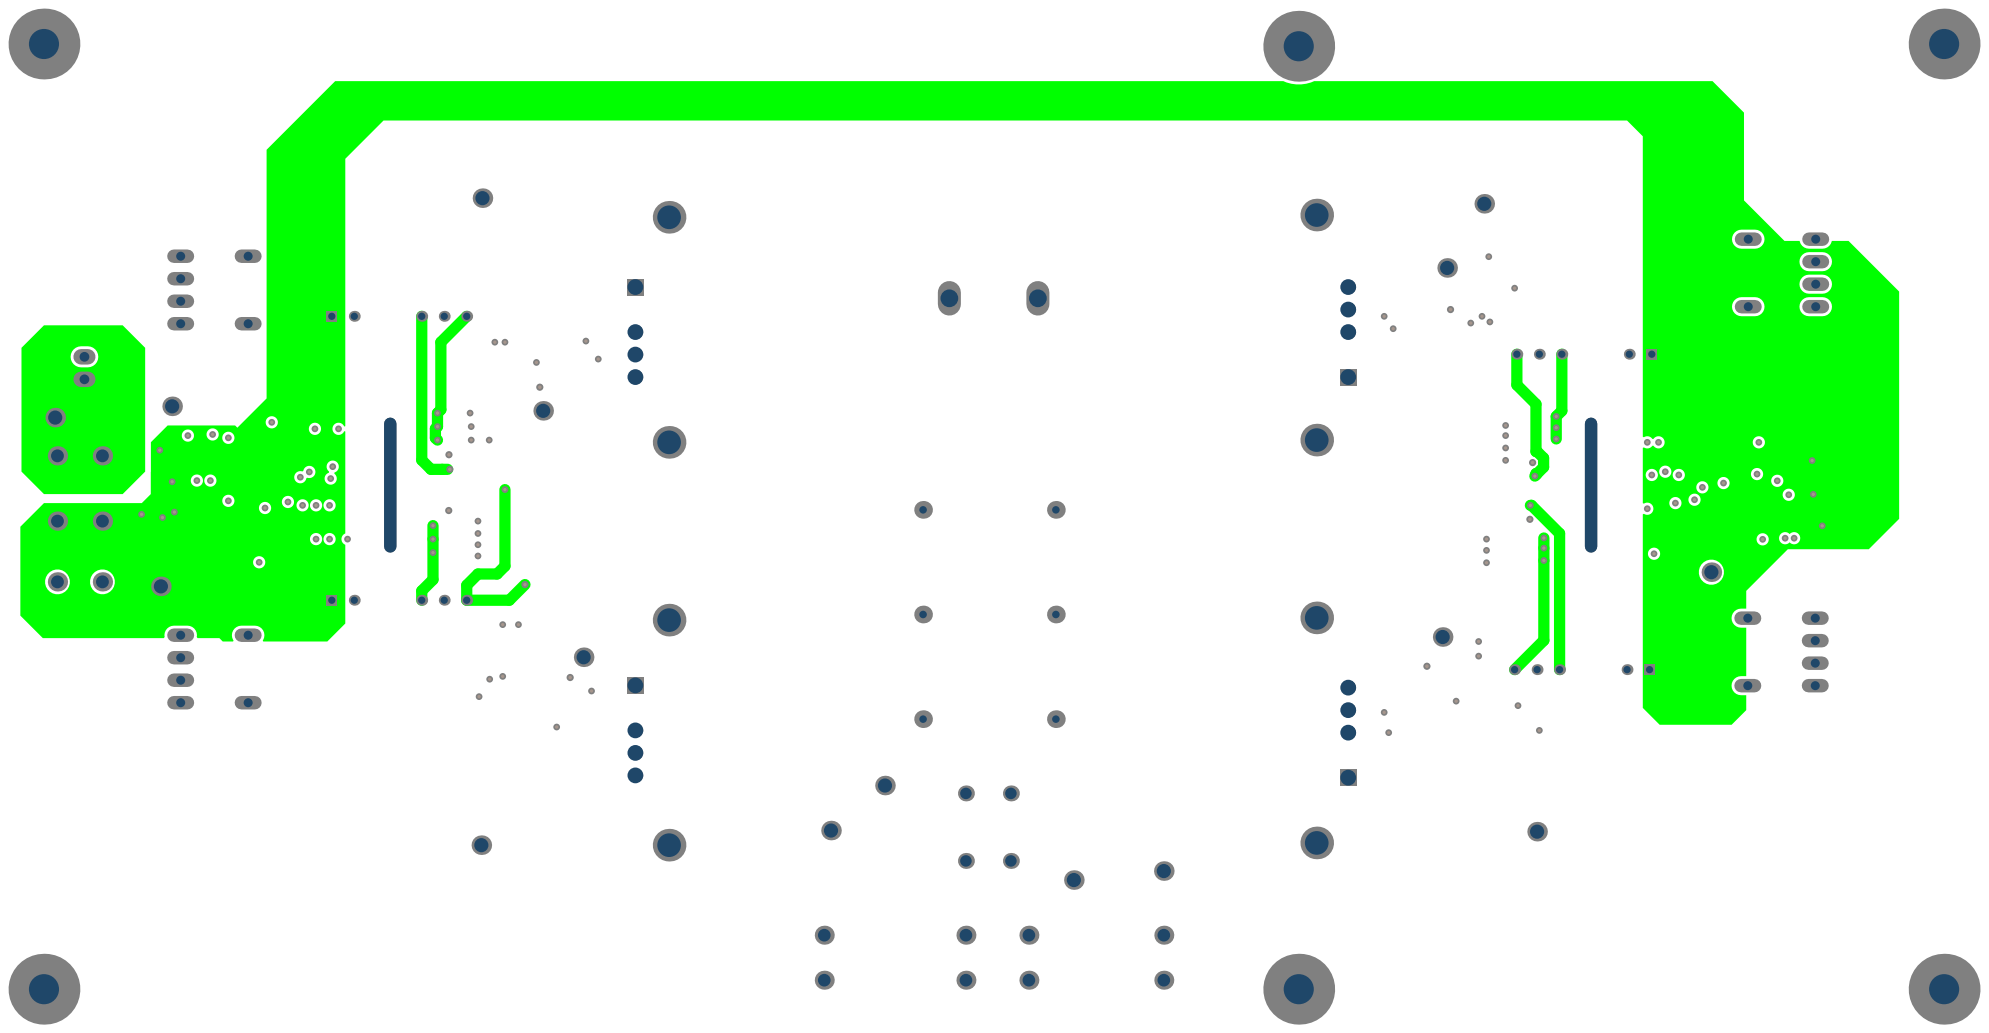
[picture p24: page 3]

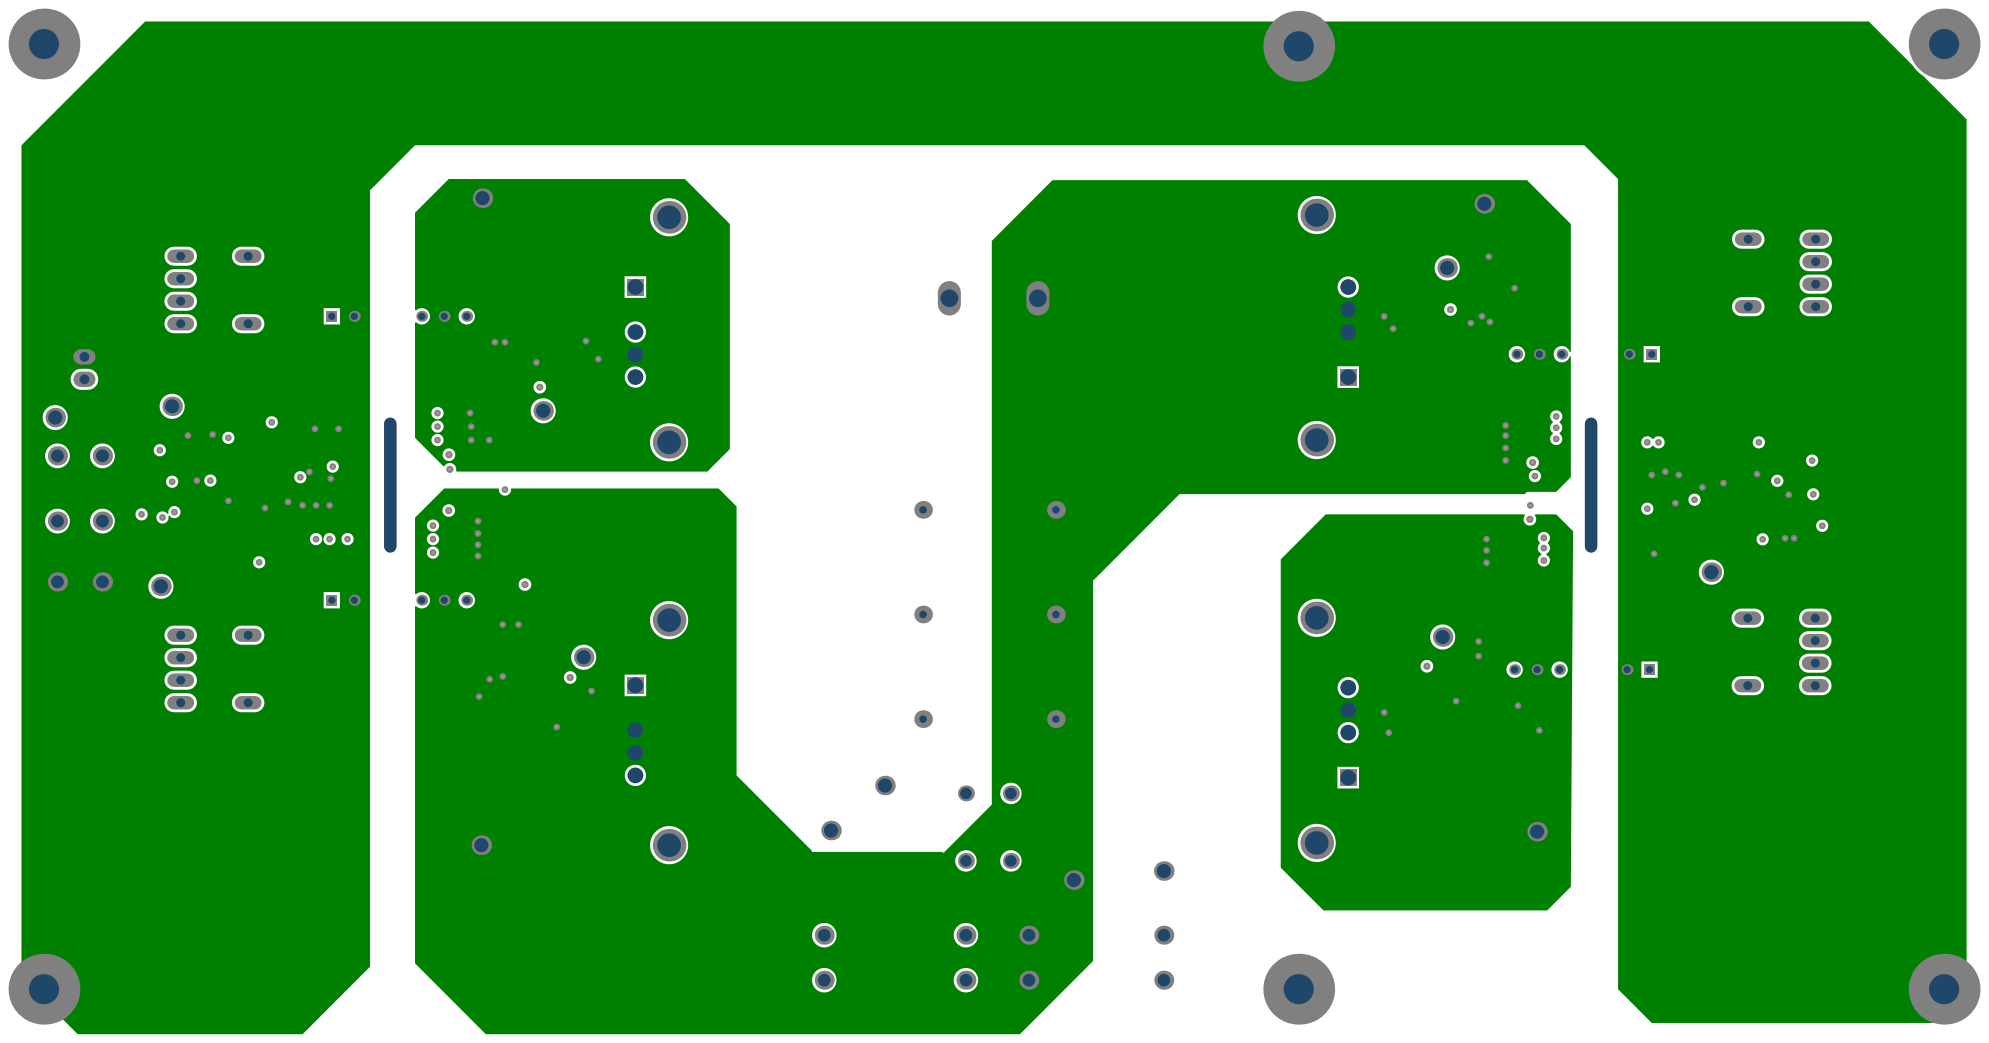
[picture p25: page 4]

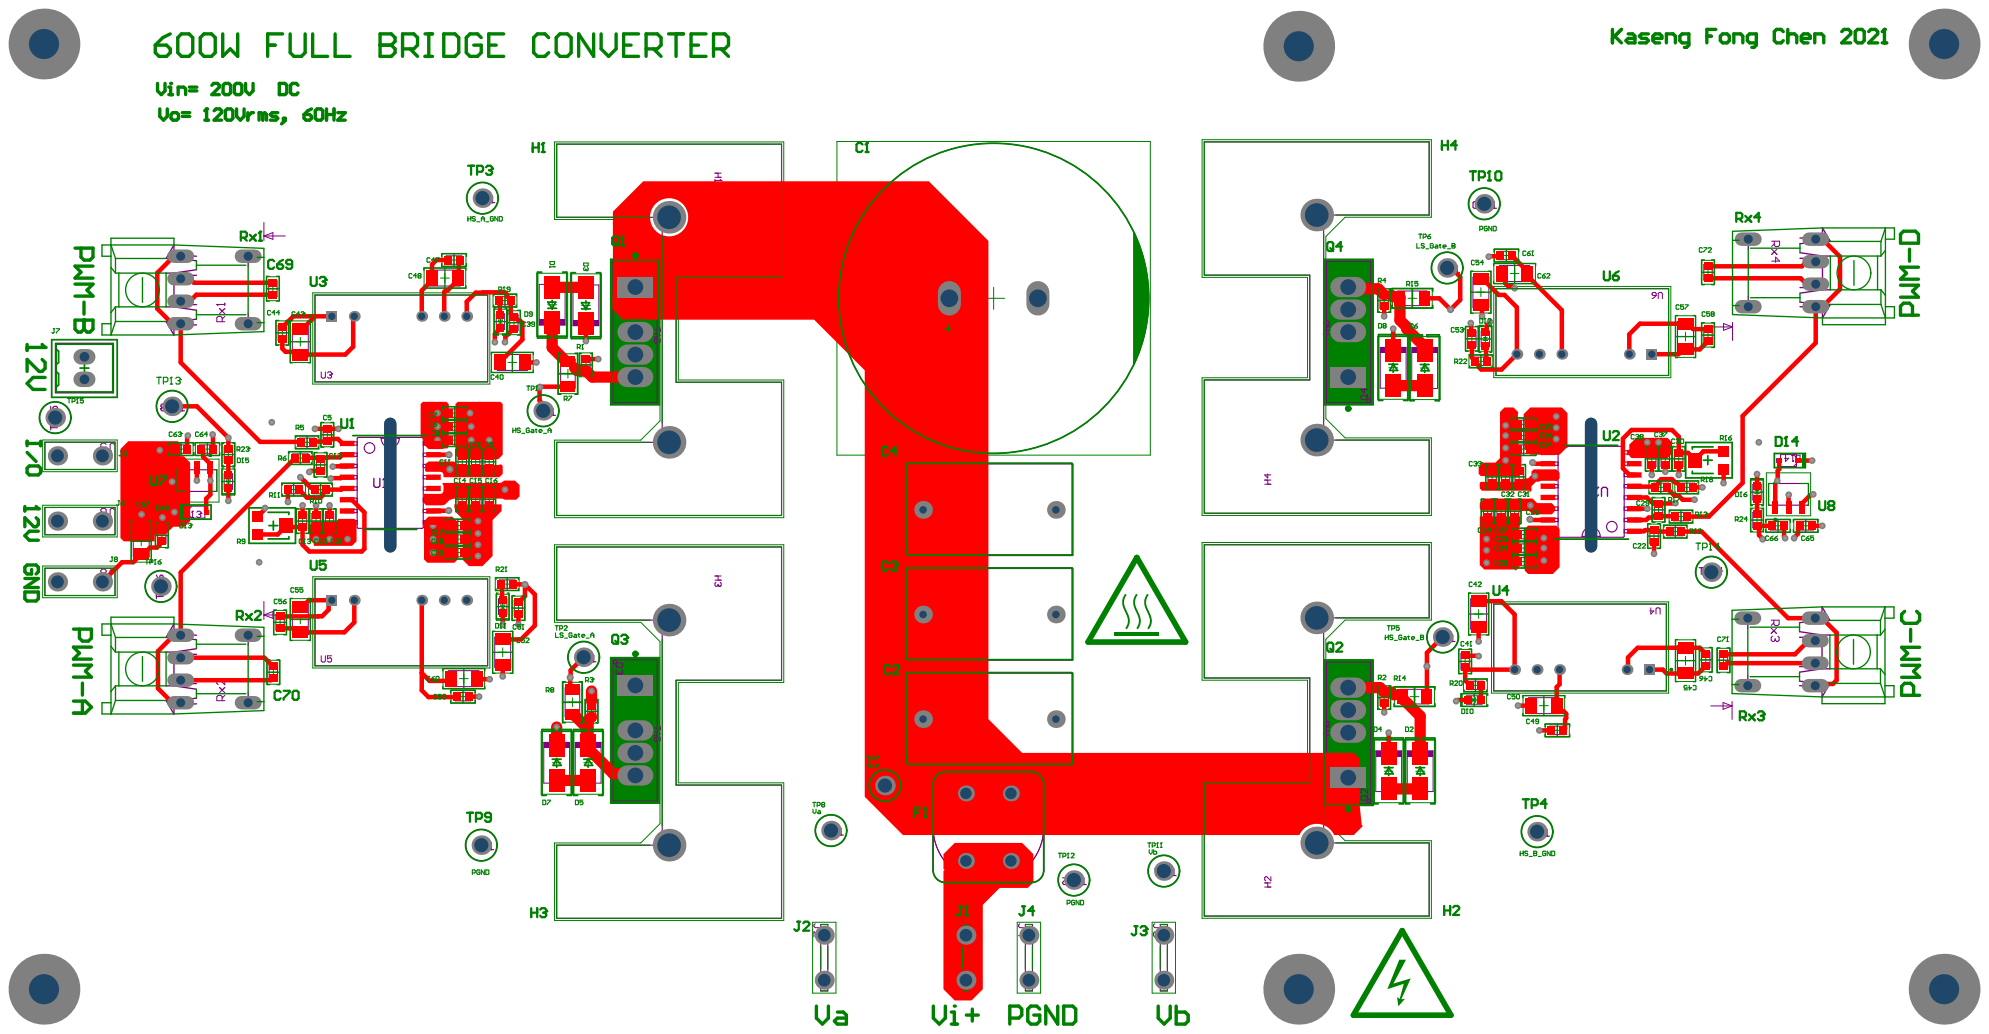
[picture p26: page 5]
