JCA98/Proyecto-el-ctrico/(list of files, drawings)

Other design files:
PCB/Ciclador de baterías.PrjPcb
PCB/diseñosjasiel/sch jasiel.SchLib
PCB/Entradas.SchDoc
PCB/FLYBACK.SchDoc
PCB/GateDrivers.SchDoc
PCB/jasiel.PcbLib
PCB/librerias/KasengLib.PcbLib
PCB/librerias/KasengLIb.SchLib
PCB/PCB1.PcbDoc
PCB/Power_Card.SchDoc
