JCA98/Proyecto-el-ctrico/(commit log)

2021-05-29 Create cargadores de carros 1.pdf
2021-05-29 Create cargadores de carros 2.pdf
2021-05-29 Create Maquina de doble excitación.pdf
2021-05-29 Create PCB terminal blocks and connectors.pdf
2021-06-15 Create sch jasiel.SchLib
    [sch jasiel.SchLib]
2021-06-15 Create User Library-CR2012-0805.step
    [User Library-CR2012-0805.step]
2021-06-16 Update sch jasiel.SchLib
    [sch jasiel.SchLib]
2021-06-18 Create C0805C105Z3VACTU-pcb-part-libraries (1).zip
2021-06-18 Create T494A106M020AT-pcb-part-libraries (1).zip
2021-06-19 Create TMH_0515D-pcb-part-libraries (2).zip
2021-06-20 Create ALS70A362KE250-pcb-part-libraries (1).zip
2021-06-24 Create Ciclador de baterías.plecs
2021-07-03 Create ALS70A362KE250-pcb-part-libraries (2).zip
2021-07-03 Create RCL121847R0JNEK-pcb-part-libraries (1).zip
2021-07-06 Create Ciclador de baterías.PrjPcb
    [Ciclador de baterías.PrjPcb]
2021-07-06 Create Ciclador de baterías.PrjPcbStructure
2021-07-06 Create Ciclador de baterías.~(1).PrjPcb.Zip
2021-07-06 Create Ciclador de baterías.~(2).PrjPcb.Zip
2021-07-06 Update Ciclador de baterías.PrjPcb
    [Ciclador de baterías.PrjPcb]
2021-07-06 Update Ciclador de baterías.PrjPcbStructure
2021-07-06 Create Ciclador de baterías.~(3).PrjPcb.Zip
2021-07-07 Create Ciclador de baterías.~(4).PrjPcb.Zip
2021-07-07 Create Ciclador de baterías.~(5).PrjPcb.Zip
2021-07-08 Create Ciclador de baterías.~(6).PrjPcb.Zip
2021-07-08 Create Ciclador de baterías.~(7).PrjPcb.Zip
2021-07-08 Create PCB1 PCB ECO 07-07-2021 06-02-23 p. m..LOG
2021-07-08 Create PCB1 PCB ECO 07-07-2021 06-05-14 p. m..LOG
2021-07-08 Create Ciclador de baterías.~(8).PrjPcb.Zip
2021-07-08 Create PCB1 PCB ECO 07-07-2021 07-59-10 p. m..LOG
2021-07-08 Create PCB1 PCB ECO 07-07-2021 08-08-08 p. m..LOG
2021-07-08 Create PCB1 PCB ECO 07-07-2021 08-08-54 p. m..LOG
2021-07-08 Create PCB1 PCB ECO 07-07-2021 08-11-50 p. m..LOG
2021-07-08 Create PCB1 PCB ECO 07-07-2021 08-14-34 p. m..LOG
2021-07-08 Create RCL121847R0JNEK-pcb-part-libraries (2).zip
2021-07-08 Create RN73H2BTTD1001B10-pcb-part-libraries (1).zip
2021-07-08 Create PCB1 PCB ECO 08-07-2021 03-45-12 p. m..LOG
2021-07-08 Create PCB1 PCB ECO 08-07-2021 03-53-28 p. m..LOG
2021-07-10 Create Ciclador de baterías.~(9).PrjPcb.Zip
2021-07-10 Create PCB1 PCB ECO 09-07-2021 03-38-15 p. m..LOG
2021-07-10 Create PCB1 PCB ECO 09-07-2021 04-24-09 p. m..LOG
2021-07-10 Create PCB1 PCB ECO 09-07-2021 04-26-27 p. m..LOG
2021-07-10 Create PCB1 PCB ECO 09-07-2021 04-27-50 p. m..LOG
2021-07-10 Create PCB1 PCB ECO 09-07-2021 04-30-47 p. m..LOG
2021-07-10 Create PCB1 PCB ECO 09-07-2021 04-32-05 p. m..LOG
2021-07-11 Create Ciclador de baterías.pdf
2021-07-11 Create CGA2B3X7R1V104M050BB-pcb-part-libraries (1).zip
2021-07-11 Create Ciclador de baterías.~(10).PrjPcb.Zip
2021-07-11 Create PCB1 PCB ECO 10-07-2021 06-18-30 p. m..LOG
2021-07-11 Create PCB1 PCB ECO 10-07-2021 06-20-33 p. m..LOG
2021-07-11 Create PCB1 PCB ECO 10-07-2021 07-49-56 p. m..LOG
2021-07-13 Create Ciclador de baterías.~(11).PrjPcb.Zip
2021-07-14 Create PCB1 PCB ECO 13-07-2021 08-00-31 p. m..LOG
2021-07-16 Create Ciclador de baterías.~(12).PrjPcb.Zip
2021-07-16 Create Design Rule Check - PCB1.~(1).#(Deleted).html.Zip
2021-07-16 Create Design Rule Check - PCB1.drc
2021-07-16 Create Design Rule Check - PCB1.html
2021-07-16 Revert "Create PCB1.~(99).PcbDoc.Zip"
    This reverts commit 53c4fb619e472a6903e3210a36b3206ac8b9a983.
2021-07-16 Revert "Update PCB1.PcbDoc"
    This reverts commit bceca5a70ca79e4197dc14b93c721d89434385ef.
    [PCB1.PcbDoc]
2021-07-16 Revert "Update Power_Card.SchDoc"
    This reverts commit 14217a70f81e0a37fe2997712d254cb0caabc8f8.
    [Power_Card.SchDoc]
2021-07-16 Update Design Rule Check - PCB1.drc
2021-07-16 Update Design Rule Check - PCB1.html
2021-07-17 Create PCB1 PCB ECO 16-07-2021 04-55-36 p. m..LOG
2021-07-17 Create PCB1 PCB ECO 17-7-2021 12-46-17.LOG
2021-07-17 Create PCB1 PCB ECO 17-7-2021 12-31-41.LOG
2021-07-18 Create Ciclador de baterías.~(13).PrjPcb.Zip
2021-07-18 Create PCB1 PCB ECO 18-7-2021 08-57-24.LOG
2021-07-18 Create PCB1 PCB ECO 18-7-2021 09-38-03.LOG
2021-07-20 Create PCB1 PCB ECO 19-07-2021 09-13-27 p. m..LOG
2021-11-07 Update Ciclador de baterías.plecs
2021-11-07 Create Ciclador de baterías.OutJob
